AleNimo/Bode_Analyzer/Imagenes Manuales/Conectores_BNC.jpg

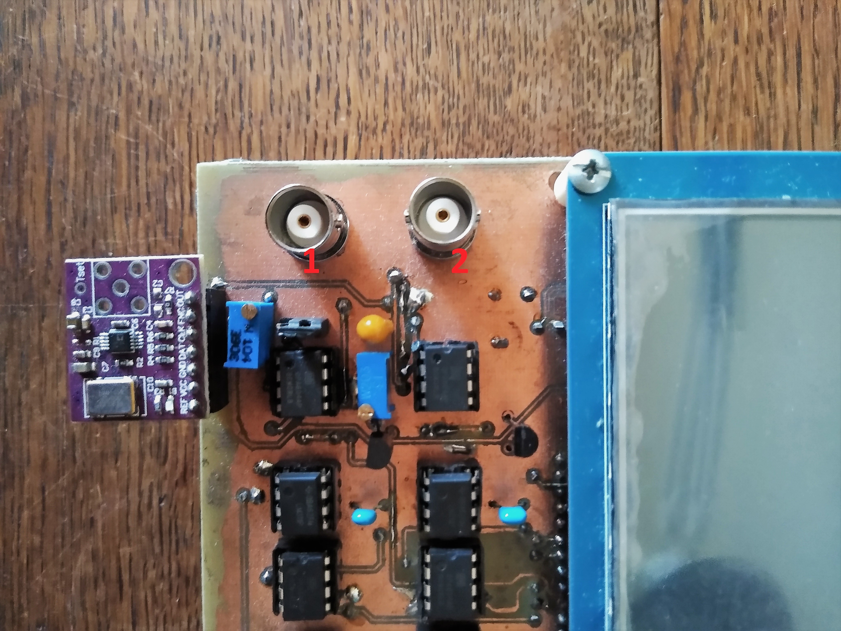
Imagenes Manuales/Conectores_BNC.jpg
