AleNimo/Bode_Analyzer/Imagenes Manuales/Cables_Alimentacion.jpg

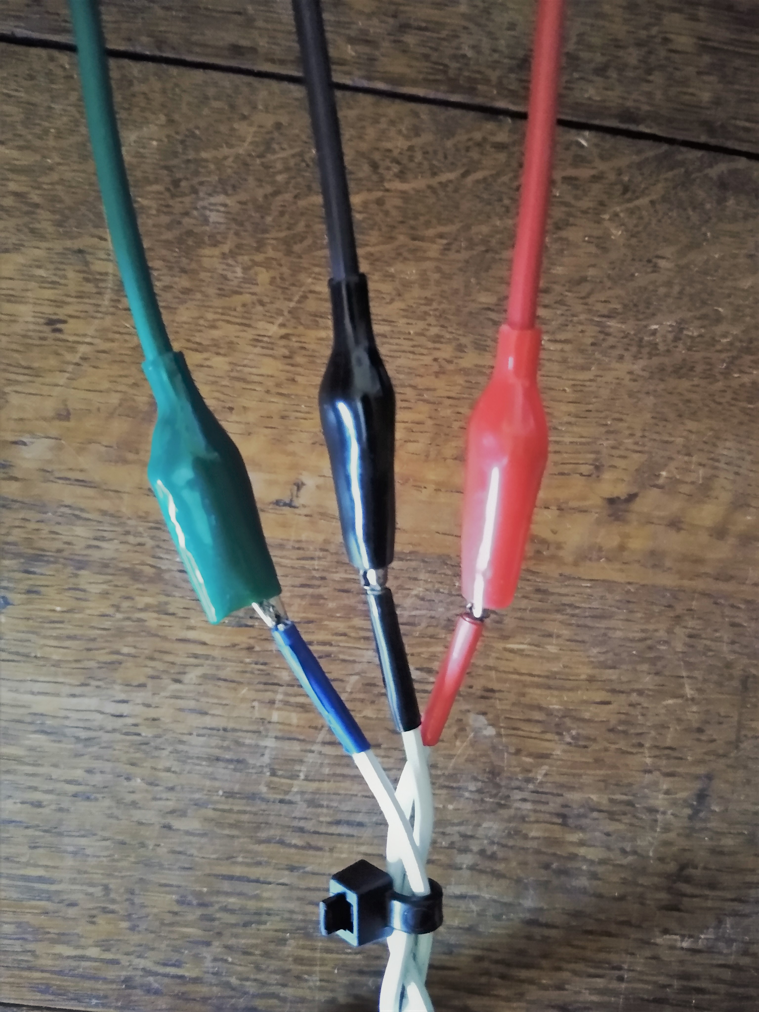
Imagenes Manuales/Cables_Alimentacion.jpg
