AleNimo/Bode_Analyzer/Bode_Analyzer Paper.pdf

# Bode Analyzer

Medicion de magnitud y fase de transferencias de filtros electr ´ | onicos. ´

1

st Alejo Domínguez Nimo

UTN FRBA
CABA, Argentina
adomnguez@frba.utn.edu.ar

2

nd Joaquín Mariano Pineiro ˜

UTN FRBA
CABA, Argentina
jpineiro@frba.utn.edu.ar

Abstract—Conocer y caracterizar la respuesta de un filtro de un sistema LTI (lineal e invariante en el tiempo) resulta de gran utilidad para cualquier proyecto electronico, en tanto ´ que permite corroborar aquella respuesta física con la calculada analíticamente y simulada. Este trabajo detalla el desarrollo de un dispositivo capaz de medir la magnitud y la fase de la transferencia de un filtro de forma automatizada, a partir de un barrido en frecuencia acondicionado por un hardware externo y posterior procesamiento digital. Como resultado se obtuvo un dispositivo capaz de medir frecuencias entre 1Hz a 20KHz, con modulo entre 0dB y -45dB. ´
Index Terms—Module, Phase, Filter, Bode, OPAMP, Frequency
I. INTRODUCCION´

A la hora de disenar un filtro, los pasos a seguir son ˜
diseno, simulaci ˜ | on e implementaci ´ | on. Si bien la simulaci ´ | on´
permite corroborar la plantilla de diseno, y determinar si el ˜ filtro produce el efecto deseado a distintas frecuencias, los componentes que constituyen la arquitectura del filtro, estan´ sometidos a distintos factores de variacion como, tolerancias, ´ temperatura, ruido electrico, y a otros factores vinculados ´ con la tecnología de fabricacion del componente elegido. ´ Muchos de estos efectos pueden ser simulados, pero otros resultan difíciles de computar, o por lo menos requieren una verificacion experimental. Por lo tanto, dependiendo de la ´ importancia del comportamiento del filtro, no es trivial conocer la respuesta real del mismo.
Esta verificacion experimental puede ser implementado con ´ otros instrumentos de medicion, como un osciloscopio y un ´ generador de senales. Sin embargo, lo tedioso y dependi- ˜
ente del operario que es este metodo de medici ´ | on resulta ´
en mediciones prolongadas en el tiempo y con alto nivel
de incertidumbre (en comparacion a una medici ´ | on con un ´
dispositivo dedicado, como la serie de productos “STEMlab” de Redpitaya [1], o el dispositivo “Bode 100” de OMICRON LAB [2]). Por estas razones, este trabajo propone una medicion´ automatizada de las magnitudes anteriormente mencionadas, a partir de un procesamiento analogico en conjunto con uno ´ digital.
| | II. MARCO TEORICO ´
A. Sistemas Lineales e Invariantes en el Tiempo
El termino sistema es sumamente amplio y abstracto. Sin ´ embargo un enfoque general lo concibe como una estructura
o diseno que opera sobre se ˜ | nales de modo de producir alg ˜ | un´
efecto sobre ellas. Particularmente, no resulta necesario determinar la constitucion f ´ ísica del sistema sino sus relaciones funcionales de forma tal de abstraerse de su construccion´ física.
Se denomina sistema (H) a un proceso que transforma senales temporales que ingresan a su entrada (x(t), x[n]) ˜ en otras que egresan de su salida (y(t), y[n]), mediante la interconexion de componentes, dispositivos o incluso ´ subsistemas.

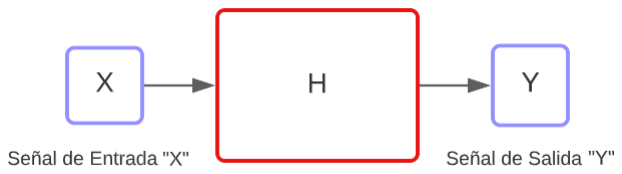
[picture p3: figure]

Fig. 1. La senal de entrada x(t) es transformada por el sistema (operador H), ˜ dando como resultado la senal de salida y(t) ˜

Los sistemas pueden ser descriptos en terminos matem ´ | aticos ´
a partir de ecuaciones algebraicas o ecuaciones diferenciales como y(t) = 2x

2
(t−1) ó y

′
(t) + 2y(t) = 4x(t)
. Adoptando el
concepto de transferencia, donde una funcion de excitaci ´ | on (de ´
entrada x(t)
) ingresa al sistema, y se convierte en una funcion´ de salida, que puede ser descripta a partir del sistema cono-
ciendo la funcion matem ´ | atica que lo describe: ´ | y(t) = T[x(t)

].
Existen muchas clasificaciones para los sistemas, pero particularmente los que interesan son los electricos que responden ´ a cuestiones físicas. Sus características principales son: invariabilidad temporal y linealidad. Un sistema se denomina lineal si cumple simultaneamente con las propiedades de aditividad ´
(1) y homogeneidad (2).

T[x1(t) + x2(t)

] = y1(t) + y2(t)
(1)
T[α · x(t)

] = α · y(t)
(2)

Un sistema es invariante en el tiempo si el comportamiento y características del mismo no cambian con el transcurso del tiempo, es decir, al desplazar su entrada un tiempo t0 la respuesta original se desplaza el mismo tiempo t0, sin cambios (3).

T[x1(t)

] = y(t) ⇒ T[x1(t−t0)

] = y(t−t0)
(3)

Por lo tanto un sistema se denomina LTI si cumple con (1),
(2) y (3).
B. Respuesta al Impulso e Integral de Convolucion´
Cualquier senal temporal puede describirse en t ˜ | erminos de ´
un conjunto de senales impulso escaladas y desplazadas en el ˜ tiempo (4). Ademas, puede evaluarse la respuesta del sistema ´
a una senal impulso ˜ | δ(t)
, definida como “Respuesta Impul-
sional” (5). De esta manera, al expresar la senal ˜ | x(t) como
combinacion de se ´ | nales impulsos escaladas y desplazadas ˜
y aplicarla a un sistema LTI, se obtendra la suma de las ´ respuestas impulsionales h(t) escaladas y desplazadas. Así, puede obtenerse la respuesta del sistema sin tener que recurrir a las ecuaciones diferenciales que lo modelan.

x(t) =

Z ∞

τ=−∞

x(τ)δ(t−τ)dτ | (4)

h(t) = T[δ(t)

] = y(t)

|x(t)=δ(t)
(5)

Sabiendo esto, es posible obtener una forma matematica que ´ describe la respuesta de salida y(t) a partir de la excitacion´ x(t) y respuesta al impulso h(t)
(6):

y(t) = T

Z ∞

τ=−∞

x(τ )δ(t − τ )dτ
(6)

y(t) =

Z ∞

τ=−∞

x(τ )h(t − τ )dτ = x(t) ∗ h(t) (7)

Donde la ecuacion (7) se denomina ´ | Integral de Convolucion´ .
C. Transformada de Fourier

Hasta este punto se conoce una forma de caracterizar el sistema en terminos del tiempo. Pero un filtro se caracteriza ´
en terminos de la frecuencia. Por lo tanto es l ´ | ogico aplicarle ´
a la expresion (7) una transformada que vincule el dominio ´ temporal con el frecuencial; la transformada de Fourier F[]. Aplicando la propiedad que posee esta transformada con la
convolucion se obtiene una expresi ´ | on (8), mucho mas sencilla ´
que vincula variables de salida con entrada. De esta manera el sistema puede ser descripto en terminos del cociente entre ´ la entrada y salida (9) a partir de su modulo |H(f)
| | y su fase

ϕ(f)

F[y(t)

] = F[x(t) ∗ h(t)

] ⇒ Y(f) = X(f)

- H(f)
(8)

H(f) =

Y(f)

X(f)

=

|Y(f)

|X(f)

e

j(ϕ(Y )−ϕ(X)) = |H(f)
| · e

jϕ(f)

(9)

D. Senales Arm ˜ | onicas ´
Conociendo las expresiones que vinculan frecuencialmente
entrada y salida, ¿como se obtiene H(f)? ¿con que se ´ | nal se ˜
excita al sistema? Estas dos preguntas no resultan triviales,
pues hay una unica se ´ | nal que resulta la m ˜ | as conveniente ´
para excitar un sistema. Hay que tener cuenta que una senal ˜ normalmente es poliarmonica, es decir, que esta compuesta ´ por sumatorias de senos y cosenos. Tomando como ejemplo una senal cuadrada x(t), al excitar con ella el sistema, el ˜ mismo responde con una determinada senal y(t). Al aplicar ˜ la transformada de Fourier tanto a x(t) como a y(t), podemos obtener X(f) e Y(f) y realizar el cociente para hallar H(f) como se vio anteriormente. Sin embargo, este proceso requiere del procesamiento de las senales temporales con la transformada ˜ discreta rapida de Fourier (FFT) para poder hacer el cociente. ´
Por esta razon la se ´ | nal m ˜ | as conveniente para aplicar este ´
analisis es una se ´ | nal arm ˜ | onica sinusoidal (10). De esta manera, ´
al excitar con un seno, de la ecuacion (11) se deduce que la ´
senal de salida tambi ˜ | en ser ´ | a un seno de la misma frecuencia ´
pero con su amplitud y desfasaje afectados por H(f)

x(t) = K · e

j·w0t+ϕ0 ⇒ X(f) = K · δ(f−f0)
- e

j·ϕ0
(10)
Y(f) = K · δ(f−f0)
- e

j·ϕ0
- H(f) = K · e

j·ϕ0
- H(f0)
(11)
Y(f) = A · e

j·ϕ1 = K · e

j·ϕ0
- H(f0)
(12)
Y(f) = K · e

j·ϕ0
- |H(f0)

| · e

jϕH | (13)

Resultando en:

|H(f0)

| =

A
K

(14)

ϕH(f) = ϕ1(f) − ϕ0(f)
(15)

Entonces, midiendo la amplitud y el desfasaje existente entre x(t) e y(t) a una frecuencia f0 se obtiene facilmente ´ el valor complejo de H(f0)
, sin usar la transformada de Fourier.

III. METODOLOGÍA GENERAL

El proyecto consiste en la construccion de un circuito ´
impreso, la programacion de un software bajo la supervisi ´ | on´
de un sistema operativo FreeRTOS, en conjunto con un Framework para manejo de interfaces graficas ´ TouchGFX [3]; y la calibracion del sistema de manera de cuantizar la ´ incertidumbre de las mediciones. El circuito impreso consta de 2 capas y 130 vías, hecho con la tecnica de planchado y ´ acidado con percloruro ferrico. Los componentes que posee ´ la placa son resistencias y capacitores SMD 0805, y circuitos integrados DIP-8. Para la CPU se utilizo un cortex M4 ARM ´ STM32F401RE [4] embebido en una placa de STM NUCLEO-F401RE [5] y para la interfaz grafica una pantalla TFT con ´
un controlador ILI9341 [6]. La senal senoidal de excitaci ˜ | on es ´
producida por un generador de senales programable ˜ | AD9833
[7], que utiliza tecnología DDS (Direct Digital Synthesis), la cual se basa en generar una senal digital variable en el tiempo ˜
y luego realizar una conversion digital a anal ´ | ogico de dicha ´
senal. ˜

IV. MEDICION´

A. Principio de Medicion´
Como se describio anteriormente, la medici ´ | on completa ´
consiste en poder obtener la fase y modulo de la transferencia ´ de un filtro.
Para medir estos dos parametros, podr ´ | ía realizarse un
muestreo con la CPU y una posterior FFT. Sin embargo, este procedimiento para el microcontrolador utilizado resulta demasiado costoso computacionalmente, y limitante en cuanto al hardware necesario (demasiada velocidad de ADC requerida,
etc.). Por esta razon se opt ´ | o otro m ´ | etodo de medici ´ | on, en el ´
que la amplitud y el desfasaje temporal entre las dos senales ˜ se realiza de manera directa.
Para ello, se propone para |H(f)
| | | | acondicionar ambas
senales transform ˜ | andolas en valores de tensi ´ | on continua que ´
sean iguales al valor maximo de cada una respectivamente. Es- ´
tas senales continuas son le ˜ | ídas por dos canales del conversor
digital analogico (ADC) del MCU. ´
Para ΦH(f)
se propone detectar los cruces por cero de ambas senales de forma coherente, es decir en ambas pendientes ˜ ascendentes o ambas descendentes. En este caso, con un comparador se generan senales cuadradas a partir de las senoidales, ˜ para que sea mas f ´ acil determinar los instantes de tiempo a ´ evaluar de forma digital. De esta manera, el MCU deberá contar el tiempo entre flancos ascendentes o descendentes de
ambas senales (se decidi ˜ | o utilizar los ascendentes). ´
B. Diagrama en Bloques - Hardware
En la Fig. 2 se muestra un diagrama en bloques del dispositivo.
C. Acondicionamiento de Senales ˜
La generacion de una se ´ | nal continua que representa el valor ˜
pico de ambas senoidales de entrada y salida se realiza a traves de un circuito detector de pico (Fig. 3), constituido ´ por un comparador LM311 [8], un amplificador operacional OPA604APG [9], un diodo Schottky, un capacitor y un transistor mosfet canal N.
De forma breve, el funcionamiento se basa en la carga de un capacitor a traves de un comparador que se activa cuando ´ la tension de entrada es mayor a la de salida del buffer (la cual ´
es igual a la tension del capacitor). Cuando dicha tensi ´ | on de ´
salida supera levemente la de entrada (VIN), el comparador se desactiva y el capacitor mantiene su tension por un tiempo ´ relativamente alto dado que la descarga es a traves de la ´ corriente en inversa del diodo y la de entrada del operacional. Notar que el transistor presente se conecta en paralelo al capacitor y es controlado por una salida de la CPU. Al cambiar a otro punto de frecuencia, puede que el nuevo valor pico de salida sea menor que el medido anteriormente, por lo que el capacitor debe descargarse antes de volver a realizar una medicion. Al activar el MOSFET, se cortocircuita el ´
capacitor descargandolo r ´ | apidamente. ´
Por otro lado, la generacion de las se ´ | nales cuadradas para ˜
detectar el desfasaje se realiza con un comparador LM311
con un lazo de realimentacion de hist ´ | eresis (Fig. 4). De esta ´
manera, ambas senales son m ˜ | as robustas al ruido que pueda ´
haber en el sistema dado que impide que este genere falsos flancos a la salida de los comparadores cuando las senales ˜ senoidales se encuentran cerca del cero.
El valor pico de la senal senoidal de excitaci ˜ | on generada ´
por el AD9833 es de apenas unas centenas de mV y ademas´ con un nivel de continua indeseado para nuestro analisis. Para ´ aprovechar mejor el rango dinamico del ADC del microcon- ´ trolador, se filtra el nivel de continua con un filtro pasa-altos,
y se amplifica la senal a una tensi ˜ | on pico de 3.3V (tensi ´ | on de ´
referencia del ADC) con un amplificador no inversor como el
de la (Fig. 5). El proposito del jumper J5 y R4 ser ´ | a explicado ´
con mas detalle en el apartado de calibracion (Secci ´ | on VIII). ´
D. Metodo de Medici ´ | on´
El metodo de medici ´ | on se subdivide en 3 etapas: ´
1) Seleccion de rango de medici ´ | on desde la UI. ´
2) Medicion de amplitud. ´
3) Medicion de fase. ´
1) El usuario controlara desde la UI el rango de frecuencias ´ que desea medir y la cantidad de puntos por decada ´
que desee. Luego con el boton ”Medir” comenzar ´ | á
la medicion, donde el MCU controlar ´ | a todo el ´
procedimiento.
2) Con los rango obtenidos de la UI, el MCU comanda al
generdor de senales para que genere una se ˜ | nal senoidal ˜
con la primer frecuencia del barrido. Se descargan los capacitores de los detectores de pico durante 1ms, y luego de un tiempo de espera para estabilizar las
senales el ADC del MCU genera una conversi ˜ | on de ´
10 muestras para ambos canales (senal de entrada y ˜ salida). Estas son promediadas; con el valor obtenido se realiza el cociente de Vout y Vin para obtener |H(f0)|.
3) Una vez realizada la medicion de amplitud, el MCU ´
comenzara la medici ´ | on de fase si el m ´ | odulo medido ´
fue mayor a -30dB, y si la frecuencia es menor a
20kHz, explicado a continuacion en la secci ´ | on de ´ | Rango
de Medicion´ . Un timer dedicado del microcontrolador
detectara un flanco ascendente de la se ´ | nal de entrada, ˜
y cuando ocurra esto, almacenara el valor actual de ´ la cuenta del mencionado timer. Al ocurrir luego un flanco ascendente pero esta vez de la senal de salida, ˜ nuevamente se almacena el valor de la cuenta. Con los valores obtenidos se calcula el desfasaje temporal, y posteriormente el desfasaje en grados sexagesimales.

Terminada la medicion, el MCU cambia a la siguiente ´ frecuencia (siguiente punto de medicion) y se repite el pro- ´ cedimiento. Una vez terminado el barrido de frecuencia, en la
UI se actualizan los graficos de m ´ | odulo y fase. ´

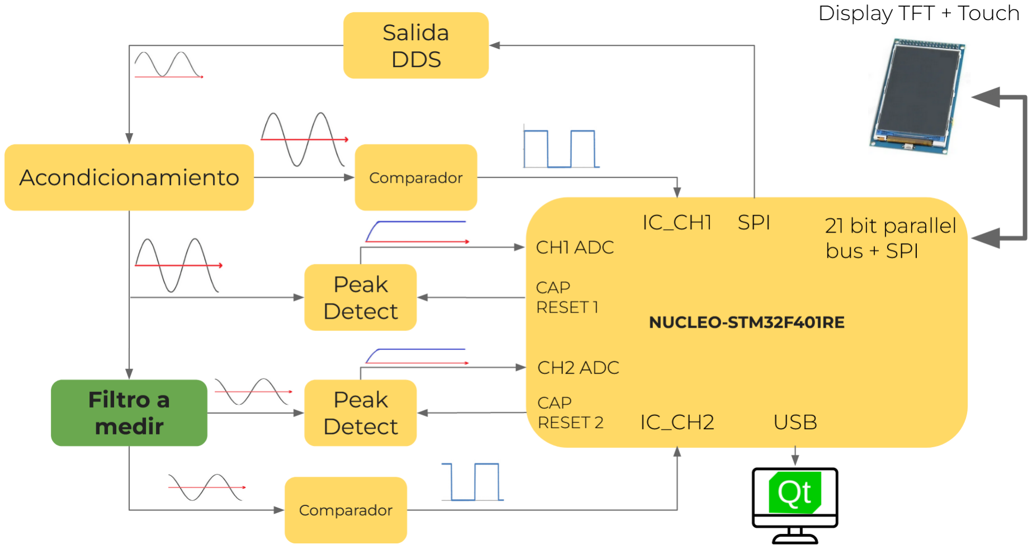
[picture p4: figure]

Fig. 2. Diagrama en bloques del hardware

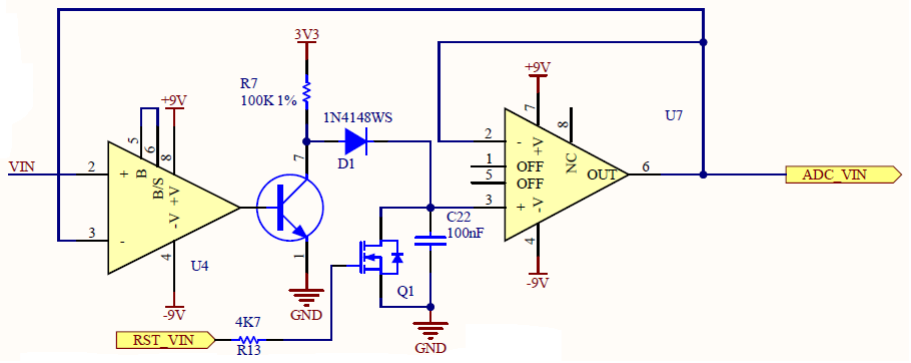
[picture p5: figure]

Fig. 3. Circuito detector de pico

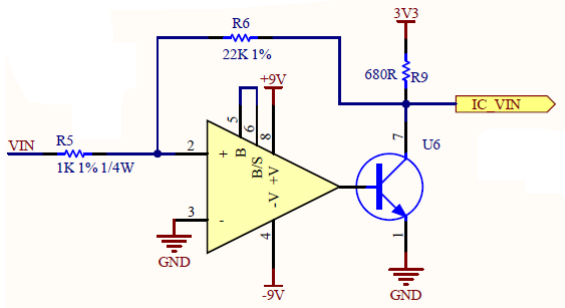
[picture p6: figure]

Fig. 4. Circuito comparador con histeresis ´

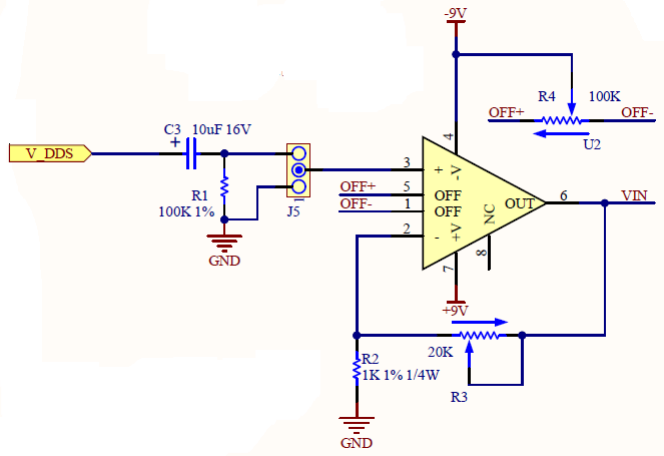
[picture p7: figure]

Fig. 5. Acondicionamiento de senal generada: filtro pasa altos y amplificador ˜ no inversor

E. Rango de Medicion´

El rango de medicion queda determinado por las carac- ´ terísticas del filtro, y las limitaciones de hardware analogico ´ y digital.
1) Magnitud: El límite superior es siempre de 0dB para toda frecuencia dado que se excita al filtro con una senal ˜ que tiene el pico igual a la tension de referencia del ADC ´ (de manera de aprovechar su rango dinamico), si el filtro es ´ activo o tiene un realce eso no se podría medir teniendo en cuenta que saturan las cuentas del conversor. Para frecuencias menores a 20Hz el rango en la medicion de magnitud queda ´

limitado entre 0dB y -16dB debido a que el ripple por la descarga del capacitor del detector de pico a baja frecuencia es considerable a amplitudes bajas (menores a 200mV). Para frecuencias mayores a 20Hz y hasta 20kHz el rango está limitado entre 0dB y -44dB dado que el detector de pico conectado a la salida del filtro puede disminuir su valor solo ´ hasta 20mV.
2) Fase: La medicion de fase est ´ | a limitada por la hist ´ | eresis ´
y el umbral propio que tiene el comparador para discernir en un cruce por cero, y ademas por las limitaciones propias del ´ timer de la CPU.
No es posible medir desfasajes de senales menores a 35mV ˜
debido a que estan por debajo de los umbrales de hist ´ | eresis ´
de los comparadores. Por esta razon solo se mide fase si el ´ modulo medido con anterioridad es mayor a -30dB (valor ´ elegido con cierto margen de seguridad). Por otro lado, tambien hay limitaciones para el desfasaje a frecuencias altas ´ (mas de 25kHz) debido a que los canales de input capture del ´ timer del microcontrolador dejan de responder de forma rapido ´ a los flancos ascendentes producidos por el comparador.
Por estas razones, la medicion de fase est ´ | a limitada a un ´
rango entre 1Hz y 20KHz, cuando la magnitud es mayor a -30dB. Teniendo en cuenta estas restricciones, los valores de fase no tienen limitaciones en su medicion: se muestran en ´ grados sexagesimales desde -180° hasta 180°.
V. FIRMWARE
A. Principio de funcionamiento

El algoritmo esta compuesto de un total de 6 tareas: ´
inicializacion del hardware ´ | ”StartHardwareTask”; monitoreo
de medicion´ ”MeasureTask”; medicion de amplitud ´ | ”Module-
Task”; medicion de fase ´ | ”PhaseTask”; envío de datos por USB
”USBTask”; refresco de pantalla que corre dentro del motor
grafico, ejecutado peri ´ | odicamente a trav ´ | es de un timer. ´
1) ”StartHardwareTask” se encarga de inicializar el motor
grafico de TouchGFX y establecer la comunicaci ´ | on´
USB.
2) ”MeasureTask” se encarga descargar los capacitores de los detectores de pico durante 1ms, recalcular y cambiar la frecuencia de la senal de entrada, generar una ˜ demora de 1s para que se estabilicen las senales, iniciar ˜
la medicion de amplitud con ´ | ”ModuleTask” y, si la
frecuencia y la magnitud medida estan dentro del rango ´ permitido, procede a realizar la medicion de fase con ´ ”PhaseTask”. Finalizadas las mediciones, se comunica con el motor grafico para actualizar las pantallas con los ´
valores de modulo y fase, y con ´ | USBTask para enviar
los datos por USB, para mostrar los graficos en la PC. ´
3) ”ModuleTask” sincronizado con ”MeasureTask”, genera 10 conversiones del ADC separadas 54.67µs entre sí de ambas senales pico de entrada y salida. Luego de la ˜ adquisicion se promedia y se calcula la magnitud en ´ decibeles.
4) ”PhaseTask” sincronizado con ”MeasureTask”, se activan las entradas que detectan flancos, y una vez sucedidos dos eventos de flancos ascendentes como se describio anteriormente, se calcula la diferencia temporal ´ y posteriormente el desfasaje en grados sexagesimales. Obtenido este valor se analizan los casos en que la fase supera 360° para descartar una mala deteccion (posible ´ a alta frecuencia), y el caso en que la fase supere -180°. Para el primero genera una nueva medicion, y para el ´ segundo se realiza un wrap de la fase para llevarla al primer cuadrante. Para este procedimiento, tambien se ´ toman 10 muestras de la fase.
5) ”USBTask” sincronizado con ”MeasureTask”, envía por
comunicacion USB la medici ´ | on de magnitud, fase y los ´
valores de frecuencia.
En la siguiente pagina se muestra un diagrama de flujo del ´ algoritmo completo (Fig. 7).

VI. APLICACION EN TOUCHGFX ´

A. Pantallas
La aplicacion est ´ | a compuesta de 2 ´ | Pantallas. La primera
consiste en el menu de configuraci ´ | on (Fig. 6) en donde el ´
usuario puede a traves de tres sliders configurar: ´
1) Frecuencia maxima de medici ´ | on. El valor l ´ | ímite de este
parametro es 1MHz ´
2) Frecuencia mínima de medicion. El valor l ´ | ímite de este
parametro es 1Hz ´
3) Puntos por decada. El valor m ´ | ínimo es 1 y el valor
maximo 600. ´

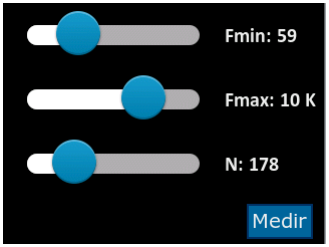
[picture p8: figure]

Fig. 6. Pantalla 1 de configuracion de frecuencia ´

La segunda es donde se muestra la magnitud y fase, en un grafico con el eje horizontal graduado en una escala ´ logarítmica para la frecuencia, y el eje vertical en una escala en decibeles para la magnitud (Fig. 8) o en grados sexagesimales al mostrar la fase (Fig. 9). Así mismo, en la esquina superior derecha de la pantalla hay un boton para cambiar entre el ´ grafico de la magnitud y la fase, y en la esquina superior ´
izquierda, un boton para volver al men ´ | u de configuraci ´ | on de ´
frecuencia.

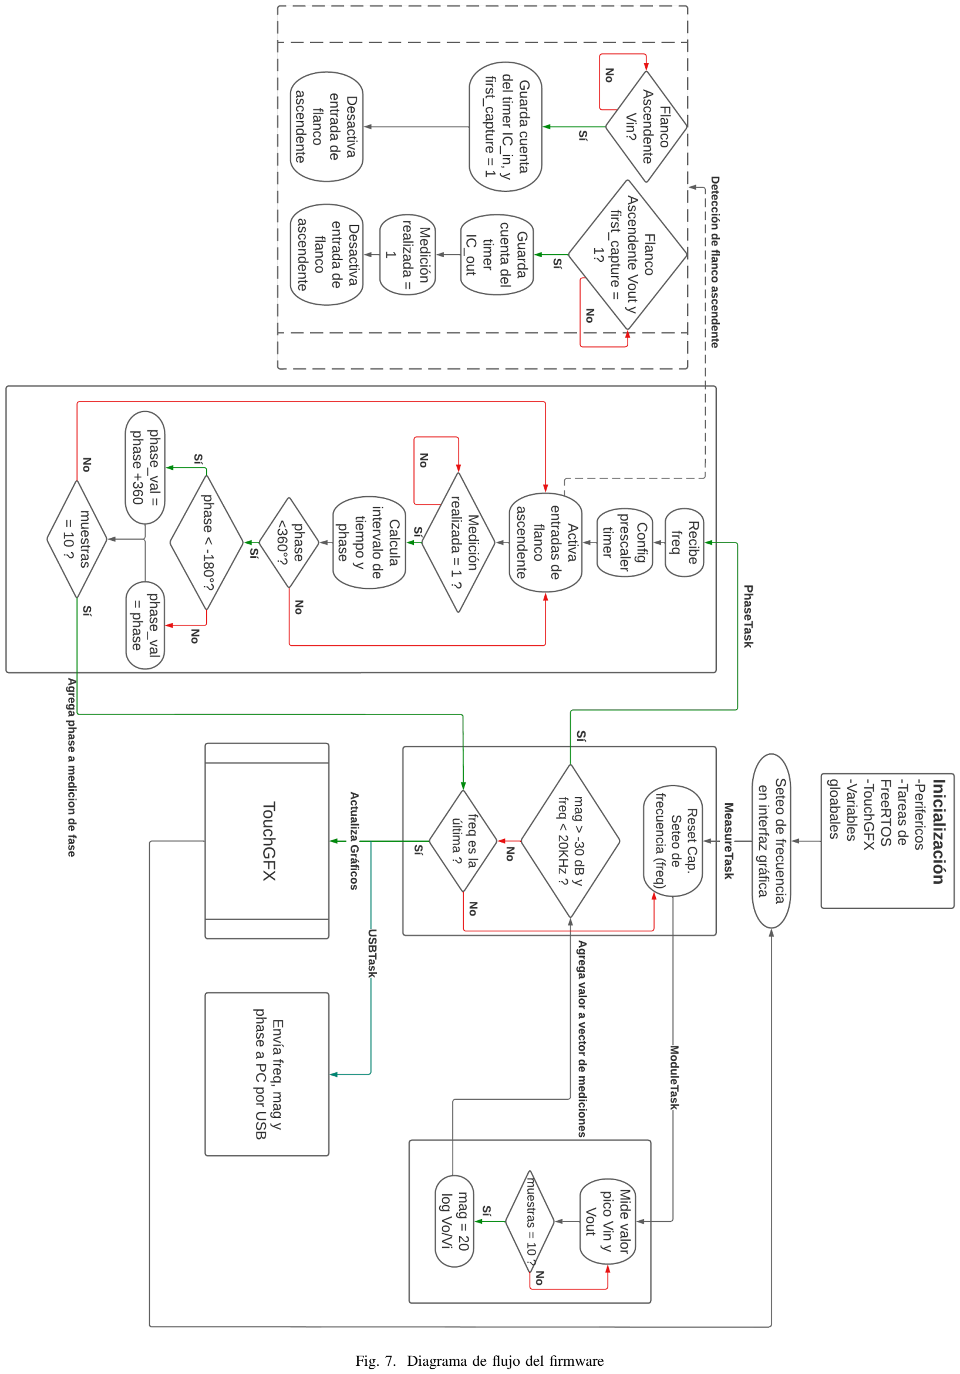
[picture p9: page 6]

Fig. 7. Diagrama de flujo del firmware

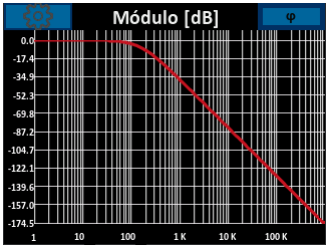
[picture p10: figure]

Fig. 8. Pantalla 2: grafico de m ´ | odulo ´

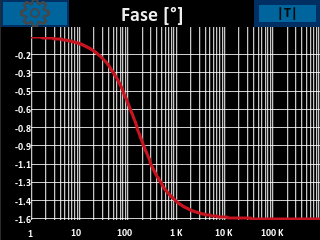
[picture p11: figure]

Fig. 9. Pantalla 2: grafico de fase ´

B. Logica de funcionamiento ´

A traves de los sliders el usuario puede configurar el ´ intervalo de frecuencia de medicion en conjunto con los puntos ´
por decada. Al presionar el bot ´ | on ”Medir”, se calcula el valor ´
maximo y m ´ | ínimo de frecuencia que se va a graficar en
pantalla. La escala horizontal siempre mostrara potencias de ´ 10 como decadas, por ejemplo, si se selecciona una frecuencia ´
mínima de 3Hz y maxima de 500Hz, la medici ´ | on ser ´ | a desde ´
3Hz hasta 500Hz pero el grafico se mostrar ´ | a desde 1Hz hasta ´
1KHz.
Luego el framework se comunica con el back-end del programa para calcular las frecuencias intermedias entre la
maxima y la m ´ | ínima en una escala logarítmica, separado un
valor del otro geometricamente equidistante. Calculados todos ´ los valores, el back-end comienza la medicion. ´
Finalizada la adquisicion de datos, el back-end se comunica ´ con el framework para actualizar los graficos. ´
VII. ANALISIS DE DISTORSI ´ | ON ARM ´ | ONICA ´ | DDS

Como se menciono anteriormente, el DDS, junto con ´ el acondicionamiento realizado, es utilizado para generar
una senal arm ˜ | onica que es requerida como se aclara en la ´
teoría. Sin embargo, en la practica no ocurre que la se ´ | nal ˜
sea puramente armonica, debido a distintos factores como la ´
resolucion del conversor digital anal ´ | ogico del DDS o, en caso ´
de no ser correctamente elegido, el slew rate del operacional en la etapa de acondicionamiento. Esto provoca una distorsion´ respecto de la senal senoidal deseada. Una forma de medir ˜
que tanto se distorsiona es analiz ´ | andola en el dominio de la ´
frecuencia. Si no hubiese distorsion (caso ideal) habr ´ | ía una
sola componente. En cambio, al haber distorsion aparecen ´ otras componentes armonicas en el espectro. ´
Estas distorsiones pueden provocar un error en la medicion´ si lo suficientemente grandes, por ejemplo en la deteccion´ del pico. Por lo tanto, es necesario caracterizar este efecto para saber si el DDS seleccionado es aceptable para los requerimientos tecnologicos del sistema. Existen dos ´ criterios para garantizar que la distorsion del generador sea ´ despreciable. Como primera instancia, se compara el pico
mas alto del arm ´ | onico indeseado con medio cuanto del ADC ´
del microcontrolador, para evaluar si el armonico afecta o no ´
al codigo obtenido del conversor. Si el valor de tensi ´ | on de ´
entrada es cercano a una transicion del ADC, entonces puede ´
que el armonico afecte al c ´ | odigo, pero esto mismo sucede con ´
el ruido. Por esta razon, como segundo criterio, se compara ´ el valor eficaz de la armonica indeseada con el valor eficaz ´ del ruido. Si la distorsion comienza a ser considerablemente ´
mayor al piso de ruido, entonces ademas de una variaci ´ | on´
aleatoria en las cuentas existe una variacion en las cuentas ´
por la distorsion arm ´ | onica del generador cuando la tensi ´ | on´
de entrada esta cercana a las transiciones del ADC.

El ensayo consiste en obtener 20 curvas de tension en ´ funcion del tiempo de distintas frecuencias desde 1Hz hasta ´ 20KHz (eligiendo valores separados exponencialmente), que es el rango normal de trabajo del equipo. Luego de esto se realiza una FFT a cada curva para detectar posibles armonicas ´ no deseadas, aplicando la ventana flat-top para medir correctamente los valores pico y la hanning para distinguir
correctamente los picos si estan muy pr ´ | oximos entre s ´ | í en
frecuencia (Fig. 10 y Fig. 11).

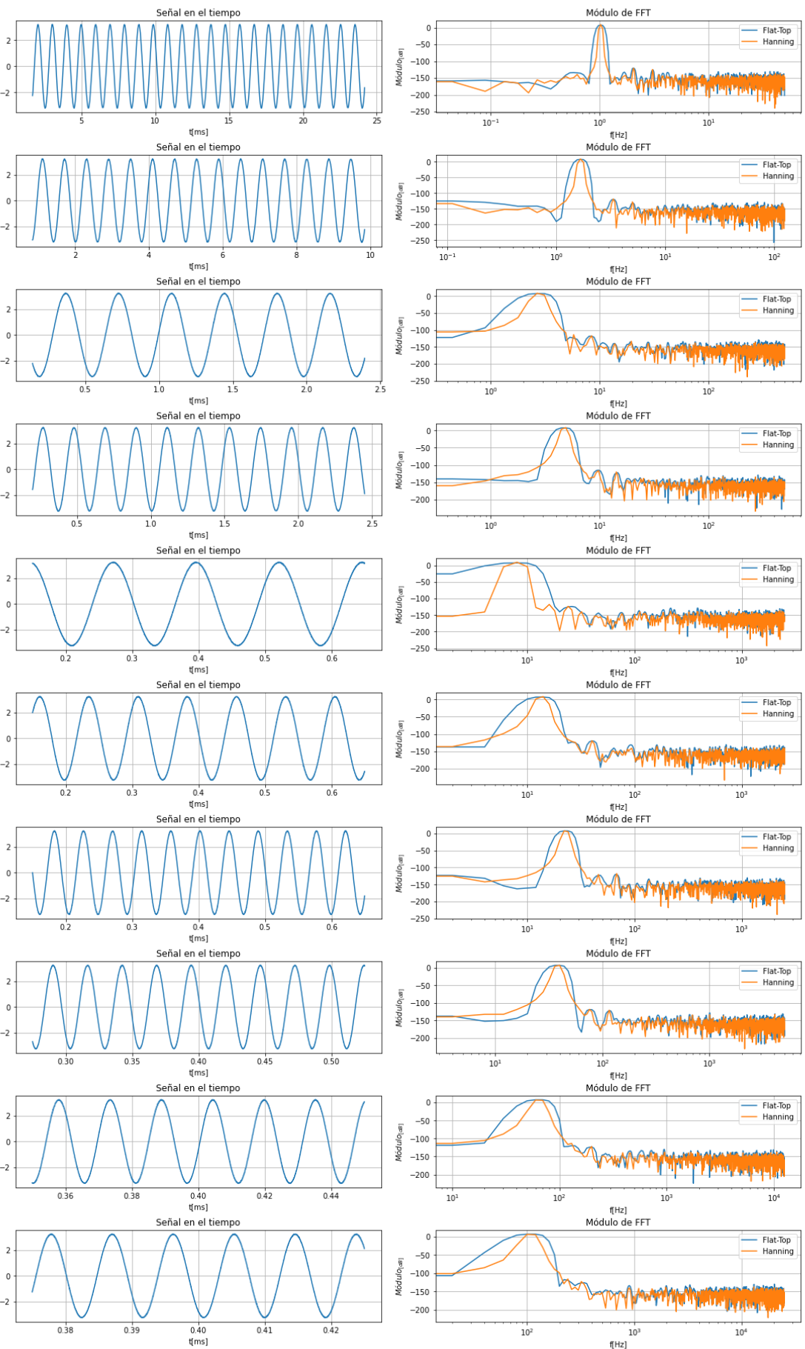
[picture p12: page 8]

Fig. 10. Ensayo de THD de 1Hz a 108.976Hz

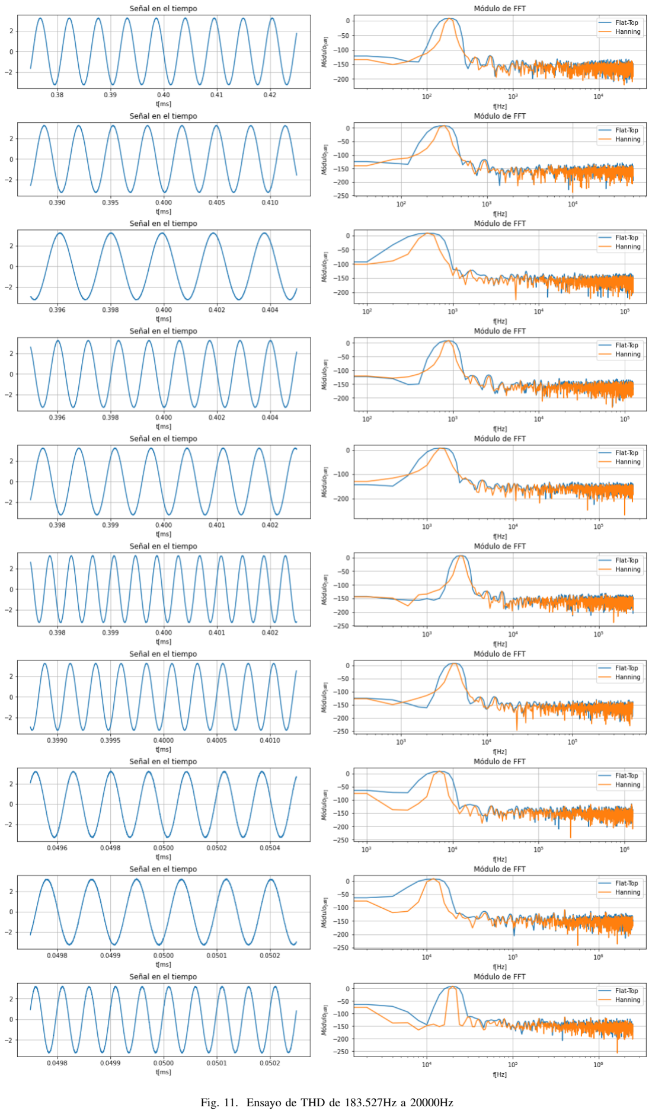
[picture p13: page 9]

Fig. 11. Ensayo de THD de 183.527Hz a 20000Hz

A. Analisis de Resultados ´
Como se observa en la Fig.10 y 11, los posibles picos que podrían deberse a la distorsion arm ´ onica, se encuentran ´ siempre a menos de -100dBV. Por lo tanto aplicando el primer criterio mencionado, se compara medio cuanto q (16) con el valor pico de -100dBV multiplicado por dos, debido a que si bien se muestra el espectro positivo, la FFT distribuye la
potencia de la senal en espectro positivo y negativo ( ˜ | Vx (17)).

q
2

=

Vref
2N · 2

=

3.3V
4096 · 2
= 402.8µV | (16)

Vx = 2 · 10

−100dB
20 | = 20µV | (17)

Como se puede observar el valor pico de las armonicas que ´ distorsionan no llegan a medio cuanto del ADC, por lo que no produce un error grosero para que el ADC resuelva entre dos cuentas adyacentes.
Por otra parte, tampoco se observa que dichas armonicas ´ superen en gran medida al piso de ruido. Entonces, estas no
producen mas error que el ruido cuando la tensi ´ | on de entrada ´
esta pr ´ | oxima a una transici ´ | on del ADC. ´

VIII. CALIBRACION´

En este apartado se explica como se realiza la calibracion´ del conversor analogico digital del MCU utilizado y a su ´ vez como utilizar los resultados obtenidos para corregir una ´
medicion de cuentas. Tambi ´ | en se explica la calibraci ´ | on de un ´
intervalo de tiempo medido con canales de input capture del MCU; al igual que para la calibracion del ADC, se desarrolla ´ el procedimiento para utilizar los resultados obtenidos en la del intervalo de tiempo.
A. Calibracion de ADC ´
Se obtiene la transferencia del ADC, y se almacena en la memoria FLASH del microcontrolador. Luego se realiza una interpolacion lineal para cada cuenta obtenida del ADC, de ´ manera de obtener la tension de entrada aproximada que la ´ genero.´
La calibracion consta de un generador de se ´ | nales arbitrario ˜
Rigol DG5070 [10] controlado con una computadora mediante USB, que genera una rampa escalonada de 1024 niveles de tension de 0V a 3.3V mantenidas 4ms cada una. El microcon- ´ trolador realiza 3 lecturas separadas 1ms entre sí comandado por la misma PC que controla al generador, y devuelve el resultado de la medicion a la PC. ´
Se promedian los valores de tension correspondientes a ´ un mismo codigo, y luego se hace un ajuste lineal de la ´ transferencia (Fig. 12). Con los valores de la transferencia ajustada a una recta se genera una matriz de 1024 filas (puntos de medicion), y dos columnas siendo la primera de ´
cuentas y la segunda de la tension de entrada en funci ´ | on de ´
la cuenta obtenida.

Teniendo esta matriz en la flash del microcontrolador (const float transf ADC[PUNTOS]), cada vez que se obtenga una

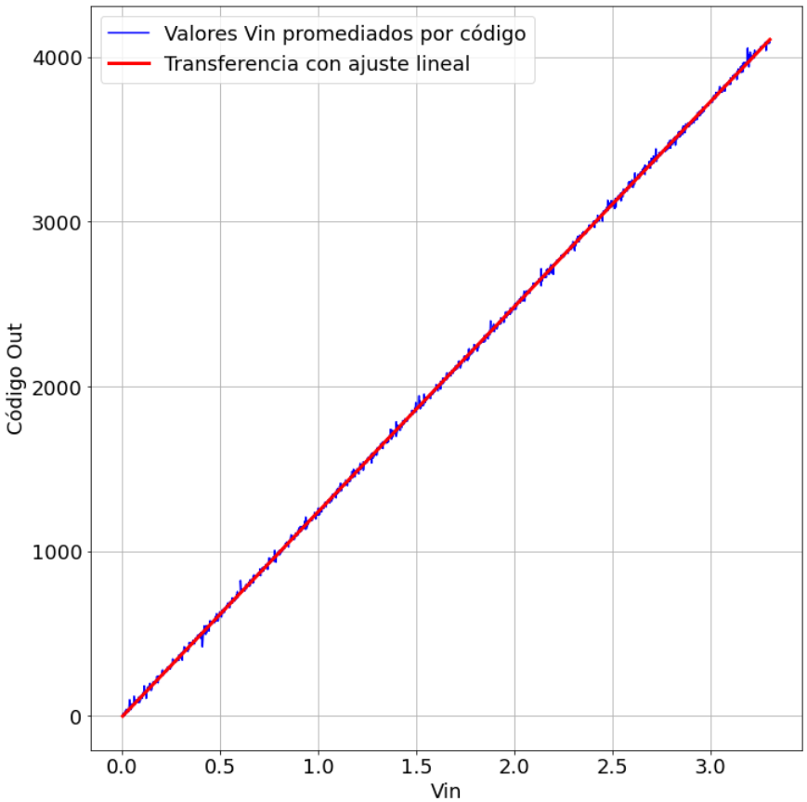
[picture p14: figure]

Fig. 12. Transferencia de ADC

cuenta (C) con el conversor se debe encontrar la cuenta de la matriz que sea inmediatamente menor a la cuenta
obtenida (CINF ), la cual tendra su respectiva tensi ´ | | | on de ´
entrada (VINF ), y la cuenta que sea inmediatamente mayor
(CSUP ) tambien con su respectiva tensi ´ | on anal ´ | ogica ( ´ | VSUP ).
Con estos valores se realiza el siguiente calculo: ´

VIN =

VINF (CSUP − C) + VSUP (C − CINF )

CSUP − CINF

| | | (18)

El cual se deduce de averiguar la ecuacion de la recta que ´ pasa por los puntos (CINF , VINF ) y (CSUP , VSUP ). En otras palabras, una interpolacion lineal. ´

B. Calibracion de timer con Input Capture ´
Se utiliza como patron un frecuenc ´ | ímetro Protek U2000A
[11] utilizado como medidor de intervalo de tiempo promediado por 100 mediciones. Con el generador de senales Agilent ˜ 33500 [12] se generan dos senales cuadradas a modo de evitar ˜ error de trigger del frecuencímetro, y se mide el desfasaje temporal de las mismas. La medicion se realiza desde 1us hasta ´ 1s con el microcontrolador y con el frecuencímetro. En este ensayo tambien se obtiene una matriz de dos columnas (valor ´
del timer y valor de patron) y 25 filas (puntos de medici ´ | | | on). ´
Las mediciones se encuentran separadas exponencialmente debido a que es mas probable que se produzcan intervalos ´ de tiempo de microsegundos hasta las decenas milisegundos, que a del orden de las decimas segundo en adelante (dado ´ que esto solo ocurre con valores de fase grandes en baja frecuencia) (Fig. 13). Luego esta matriz es almacenada en la FLASH y utilizada por el MCU en cada medicion de tiempo, ´ para corregir el resultado utilizando una interpolacion lineal ´ identica a la utilizada para calibrar el ADC. ´

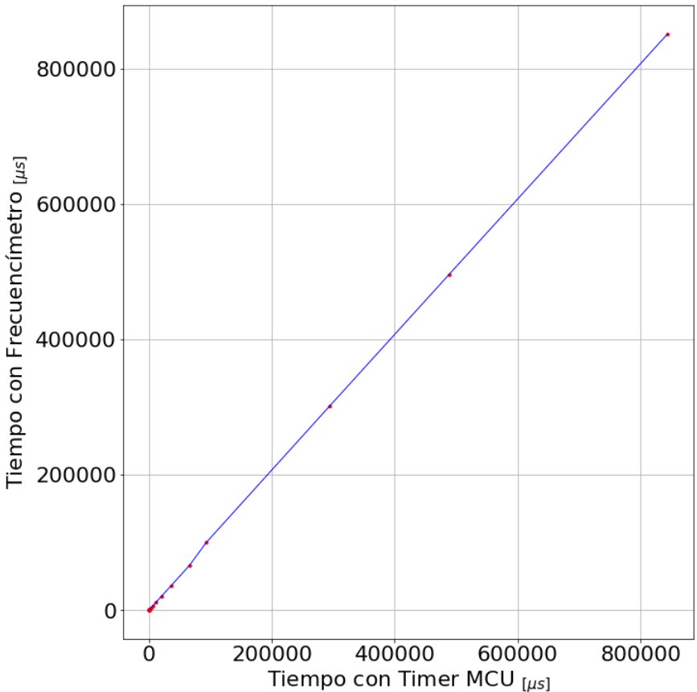
[picture p15: figure]

Fig. 13. Calibracion de medici ´ | on de intervalo de tiempo ´

IX. INCERTIDUMBRE

Se tiene incertidumbre tipo A en los valores de tension´ medidos con el ADC, y en los valores de intervalo de tiempo medidos con el timer, dado que se toman 10 muestras de
la tension de entrada al filtro, 10 muestras en la tensi ´ | on de ´
salida y 10 muestras de intervalo de tiempo respectivamente.

Estas muestras son almacenadas por el MCU, y en cada punto de medicion de frecuencia se realiza una ´ transferencia por USB con una aplicacion que se ejecuta en ´ una computadora aparte.

La aplicacion calcula los valores medios y las incertidum- ´ bres TIPO A para cada punto de frecuencia de: la tension de ´ entrada al filtro, la tension de salida y el intervalo de tiempo. ´ Con los datos aportados por los manuales del generador arbitrario utilizado en la calibracion del ADC y el manual del ´ frecuencímetro utilizado en la calibracion del input capture, ´ se calcula la incertidumbre tipo B de las mismas magnitudes mencionadas en el parrafo anterior, y con ellas las combinadas. ´ Para obtener las incertidumbres combinadas del modulo y ´ de la fase, se aplica la teoría de propagacion de incertidumbre, ´ calculando las derivadas parciales que correspondan.
Luego de varias pruebas se determina que tanto las 10 mediciones de las cuentas devueltas por el timer del input capture como las 10 mediciones de las cuentas entregadas por el ADC, resultan precisas, es decir, que practicamente no hay ´ incertidumbre en el estudio TIPO A, por lo que se considera que la mayor parte del error proviene del estudio TIPO
B. Entonces, todas las incertidumbres combinadas poseen
distribucion uniforme y se expanden al ´ | 95% con k =

√
3.

La incertidumbre en cada magnitud medida se expresa de forma grafica con una banda del intervalo de confianza sobre ´ el mismo grafico que muestra magnitud y fase por separado. ´ En las figuras 14, 15, 16, 17 se muestran como ejemplo las mediciones de un filtro pasa-bajos RC y un filtro Notch pasivo.

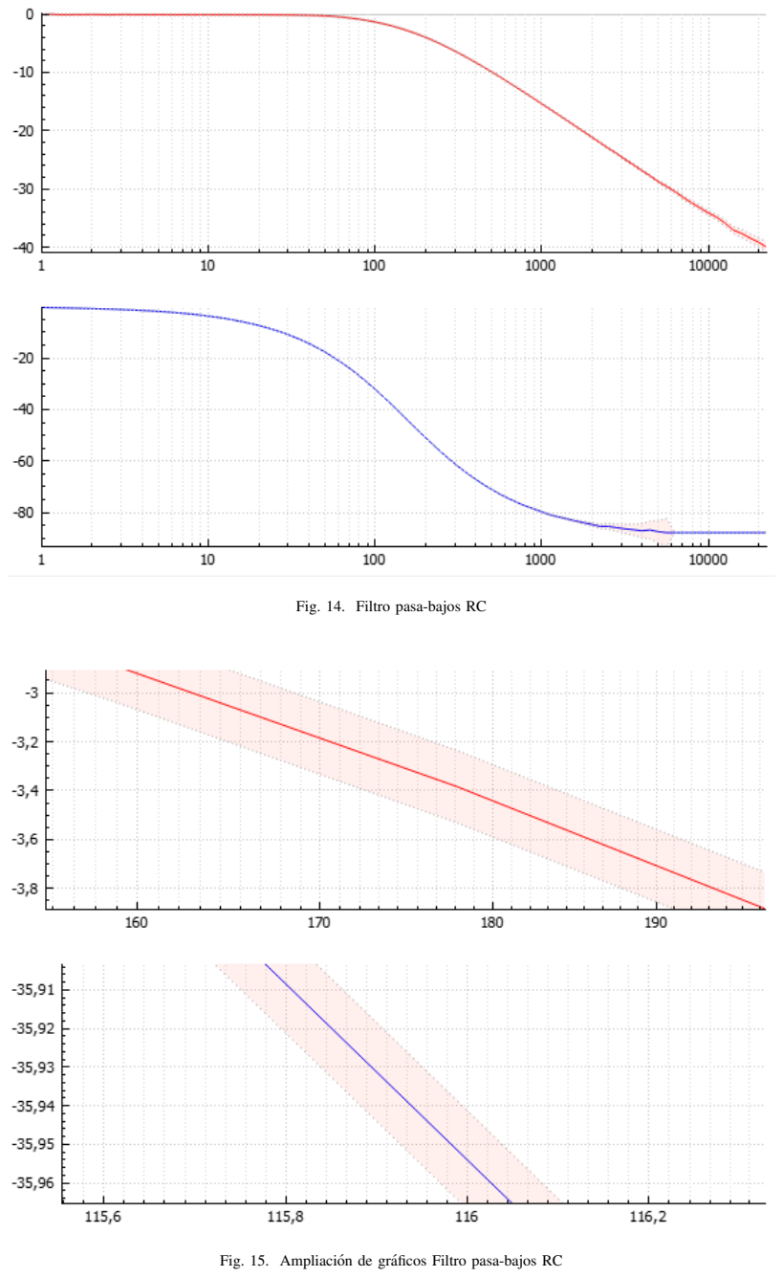
[picture p16: page 12]

Fig. 14. Filtro pasa-bajos RC

Fig. 15. Ampliacion de gr ´ | aficos Filtro pasa-bajos RC ´

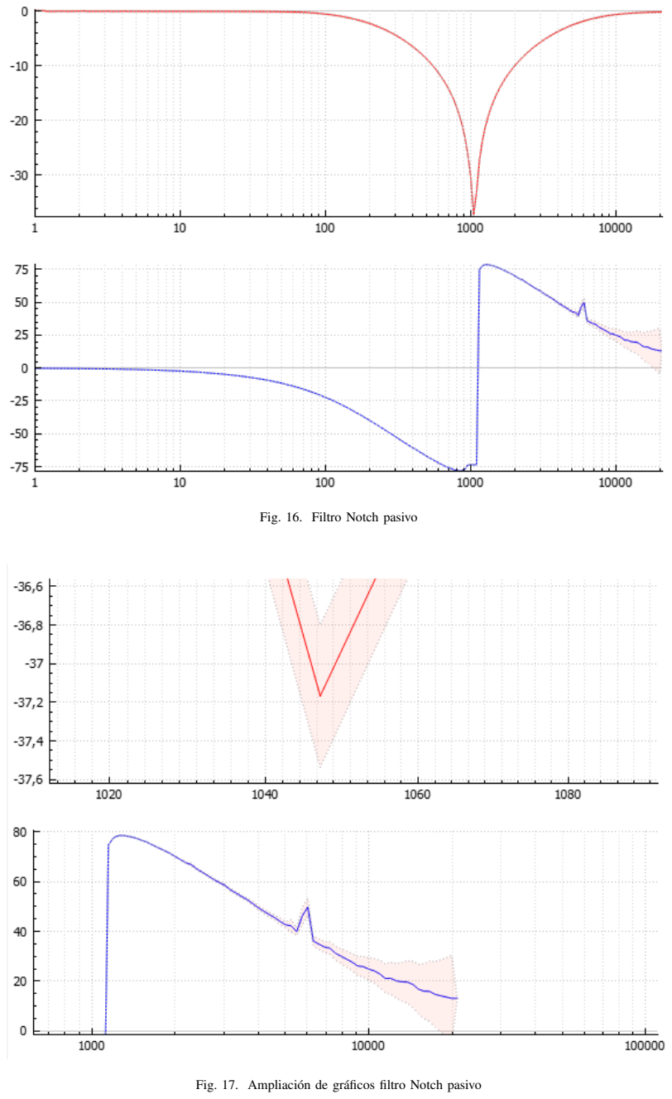
[picture p17: page 13]

Fig. 16. Filtro Notch pasivo

Fig. 17. Ampliacion de gr ´ | aficos filtro Notch pasivo ´

X. CONCLUSIONES
A. Resultados
Los resultados obtenidos del calculo de incertidumbre re- ´ flejan que el dispositivo es suficientemente preciso y que no hay casi dispersiones en las curvas medidas. Sin embargo,
a frecuencias mas altas cercanas al l ´ | ímite del dispositivo,
se puede observar como aumenta la incertidumbre en la
fase debido a que la calibracion tiene una limitaci ´ | on en la ´
resolucion del intervalo de tiempo, la cual es de 1ns. El estudio ´ tipo A hecho mostro que la incertidumbre es casi despreciable ´
en comparacion a la que introduce el frecuenc ´ | ímetro utilizado
a esas frecuencias.
Para la incertidumbre que muestra el modulo, ocurre algo ´ similar a la fase en cuanto a que aumenta la incertidumbre
pero cuando la senal a medir es peque ˜ | na. En este caso la ˜
incertidumbre la aporta casi toda la tipo A debido a que el
dispositivo intenta medir senales que est ˜ | an cercanas al piso ´
de ruido del sistema, por lo que aumenta la variacion en las ´ cuentas que arroja el ADC del MCU debido a este efecto; por lo tanto aumenta la incertidumbre tipo A.
B. Limitaciones
El ancho de banda resulto ser mucho menor al esperado ´ antes de realizar el proyecto. Por un lado porque para la
medicion de m ´ | odulo se opt ´ | o por un circuito detector de pico ´
con bajo nivel de ruido y que mida tensiones bajas en el orden de los milivolts a otro con buena respuesta en frecuencia pero con mayor nivel de ruido y por ende menor precision. ´ Por otro lado, al medir la fase, si bien los comparadores funcionan perfectamente hasta 1MHz, el input capture deja de detectar los flancos de las senales cuadradas una vez ˜ superados aproximadamente los 25kHz (por eso el límite a 20kHz dejando un margen de seguridad).
Otro problema, mencionado en la seccion de rangos, tiene ´ que ver con la medicion de amplitud a baja frecuencia y baja ´ amplitud debido que el ripple de descarga de los capacitores de los detectores de pico se vuelve considerable.
La medicion se torna ciertamente lenta, ya que le toma 1 ´ segundo a los capacitores de los detectores de pico para descargarse y cargarse nuevamente a la tension correspondiente, por ´
lo que para una medicion con mucha resoluci ´ | on en frecuencia ´
(muchos puntos), puede tardar hasta casi 10 minutos en medir.
C. Posibles Mejoras
Una forma de mejorar sustancialmente el sistema es utilizando un microcontrolador con un ADC mas r ´ apido para ´ poder muestrear la senal, y con mayor frecuencia de clock ˜ para poder realizar un algoritmo de Goertzel [13], el cual se puede tomar como una transformada de rapida Fourier pero ´
que solo devuelve un n ´ | umero complejo correspondiente al bin ´
de una frecuencia específica, la cual sería configurada para que sea la frecuencia que generamos con el DDS. De esta manera se puede reducir el hardware al maximo, retirando ´ los detectores de pico y los comparadores, y no depender del input capture del timer interno del microcontrolador. Esto tiene como consecuencia una mejora en la exactitud de la medicion´

(al evitar errores y limitaciones del hardware adicional), en el ancho de banda, ya que solo depende de la velocidad del ADC y de procesamiento del microcontrolador, y en el tiempo de medicion dado que no hay que esperar a que se descarguen y ´ se carguen los capacitores de los detectores de pico.
Una mejora a este ultimo sistema mencionado ser ´ | ía realizar
un barrido en frecuencia casi instantaneo componiendo un ´ espectro de agujas, centradas en las frecuencias de interes, y ´ luego obtener una senal asociada este espectro mediante una ˜
transformada rapida de Fourier inversa. Esta ser ´ | ía la senal que ˜
excitaría al filtro a analizar. Luego a la senal filtrada se le aplica ˜ una transformada rapida de Fourier para analizar de forma ´ simultanea como se modificaron las agujas en el espectro de ´ salida.

REFERENCES

[1] REDPITAYA, “Bode analyzer,” Disponible en https://redpitaya.com/applications-measurement-tool/bode-analyzer/. (https://redpitaya.com/applications-measurement-tool/bode-analyzer/)
[2] O. LAB, “Bode 100,” Disponible en https://www.omicron-lab.com/products/vector-network-analysis/bode-100#. (https://www.omicron-lab.com/products/vector-network-analysis/bode-100#)
[3] STM, “Touchgfx documentation,” Disponible en https://support.touchgfx.com/4.21/docs/introduction/welcome. (https://support.touchgfx.com/4.21/docs/introduction/welcome)
[4] ——, “Stm32f401xb/c and stm32f401xd/e advanced arm®-based 32-bit
mcus,” Disponible en https://www.st.com/resource/en/reference manual/ rm0368-stm32f401xbc-and-stm32f401xde-advanced-armbased-32bit-mcus-stmicroelectronics. pdf (https://www.st.com/resource/en/reference_manual/rm0368-stm32f401xbc-and-stm32f401xde-advanced-armbased-32bit-mcus-stmicroelectronics.pdf) (19/12/18).
[5] ——, | “Stm32 | nucleo-64 | boards | (mb1136),” | Disponible
en | https://www.st.com/resource/en/user manual/
um1724-stm32-nucleo64-boards-mb1136-stmicroelectronics.pdf (https://www.st.com/resource/en/user_manual/um1724-stm32-nucleo64-boards-mb1136-stmicroelectronics.pdf) (20/08/20).
[6] ILITEK, “a-si tft lcd single chip driver 240rgbx320 resolution and 262k color,” Disponible en https://cdn-shop.adafruit.com/datasheets/ILI9341. pdf. (https://cdn-shop.adafruit.com/datasheets/ILI9341.pdf)
[7] A. Devices, “Low power, 12.65 mw, 2.3 v to 5.5 v, programmable waveform generator,” Disponible en https://www.analog.com/media/en/technical-documentation/data-sheets/ad9833.pdf (https://www.analog.com/media/en/technical-documentation/data-sheets/ad9833.pdf) (04/19).
[8] T. Instruments, “Lm111, lm211, lm311 differential comparators,” Disponible en https://www.ti.com/lit/ds/symlink/lm311.pdf(03/17).
[9] ——, “Fet-input, low distortion operational amplifier,” Disponible en https://www.ti.com/general/docs/suppproductinfo.tsp?distId=26&gotoUrl=https://www.ti.com/lit/gpn/opa604 (https://www.ti.com/general/docs/suppproductinfo.tsp?distId=26&gotoUrl=https://www.ti.com/lit/gpn/opa604) (09/03).
[10] RIGOL, “Arbitrary waveform generator specifications,” Disponible en https://beyondmeasure.rigoltech.com/acton/attachment/1579/f-0051/0/-/-/-/-/file.pdf. (https://beyondmeasure.rigoltech.com/acton/attachment/1579/f-0051/0/-/-/-/-/file.pdf)
[11] PROTEK, “Frequency counter specifications,” Disponible en http://www.arivigevano.net/files/pk9100.pdf.
[12] AGILENT, | “Waveform | generator | specifications,” | Disponible
en | https://electricayelectronica.uniandes.edu.co/sites/default/files/
laboratorios/manual-33500-Op-and-Svc-US.pdf. (https://electricayelectronica.uniandes.edu.co/sites/default/files/laboratorios/manual-33500-Op-and-Svc-US.pdf)
[13] WIKIPEDIA, “Goertzel algorithm,” Disponible en https://en.wikipedia.org/wiki/Goertzel algorithm(24/01/2023). (https://en.wikipedia.org/wiki/Goertzel_algorithm)
