AleNimo/Bode_Analyzer/Imagenes Manuales/Schematic_Nucleo_power.png

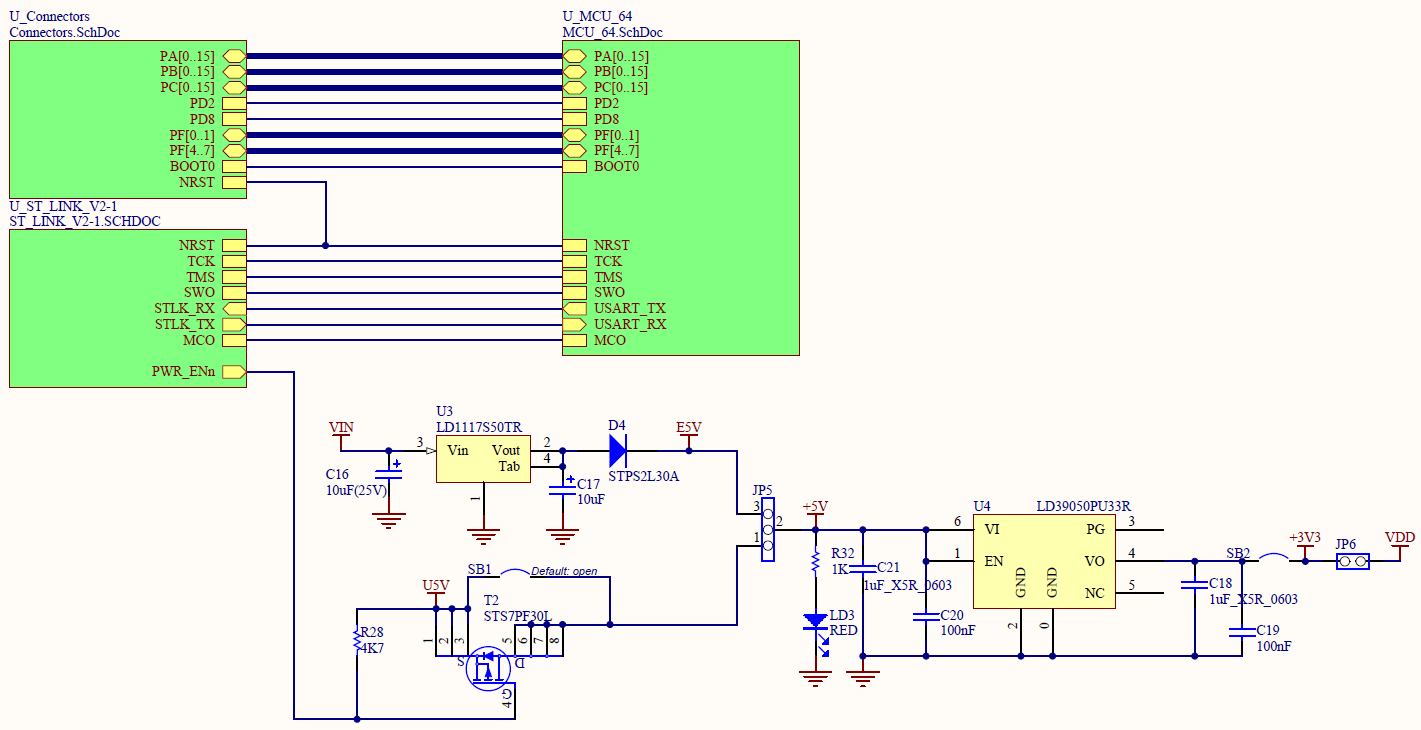
Imagenes Manuales/Schematic_Nucleo_power.png
