AleNimo/Bode_Analyzer/Imagenes Paper/ADC_raw.png

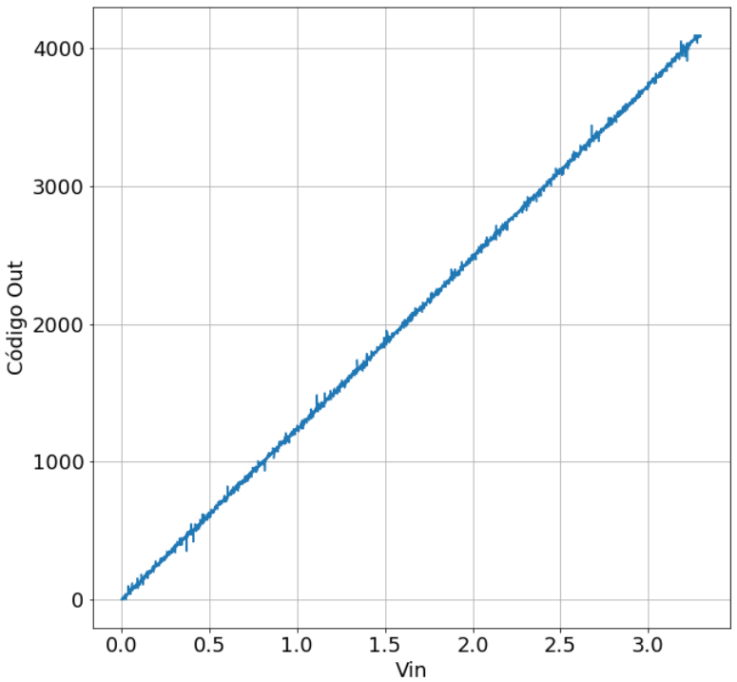
Imagenes Paper/ADC_raw.png
