AleNimo/Bode_Analyzer/Imagenes Paper/Bode Analyzer - FlowChart.png

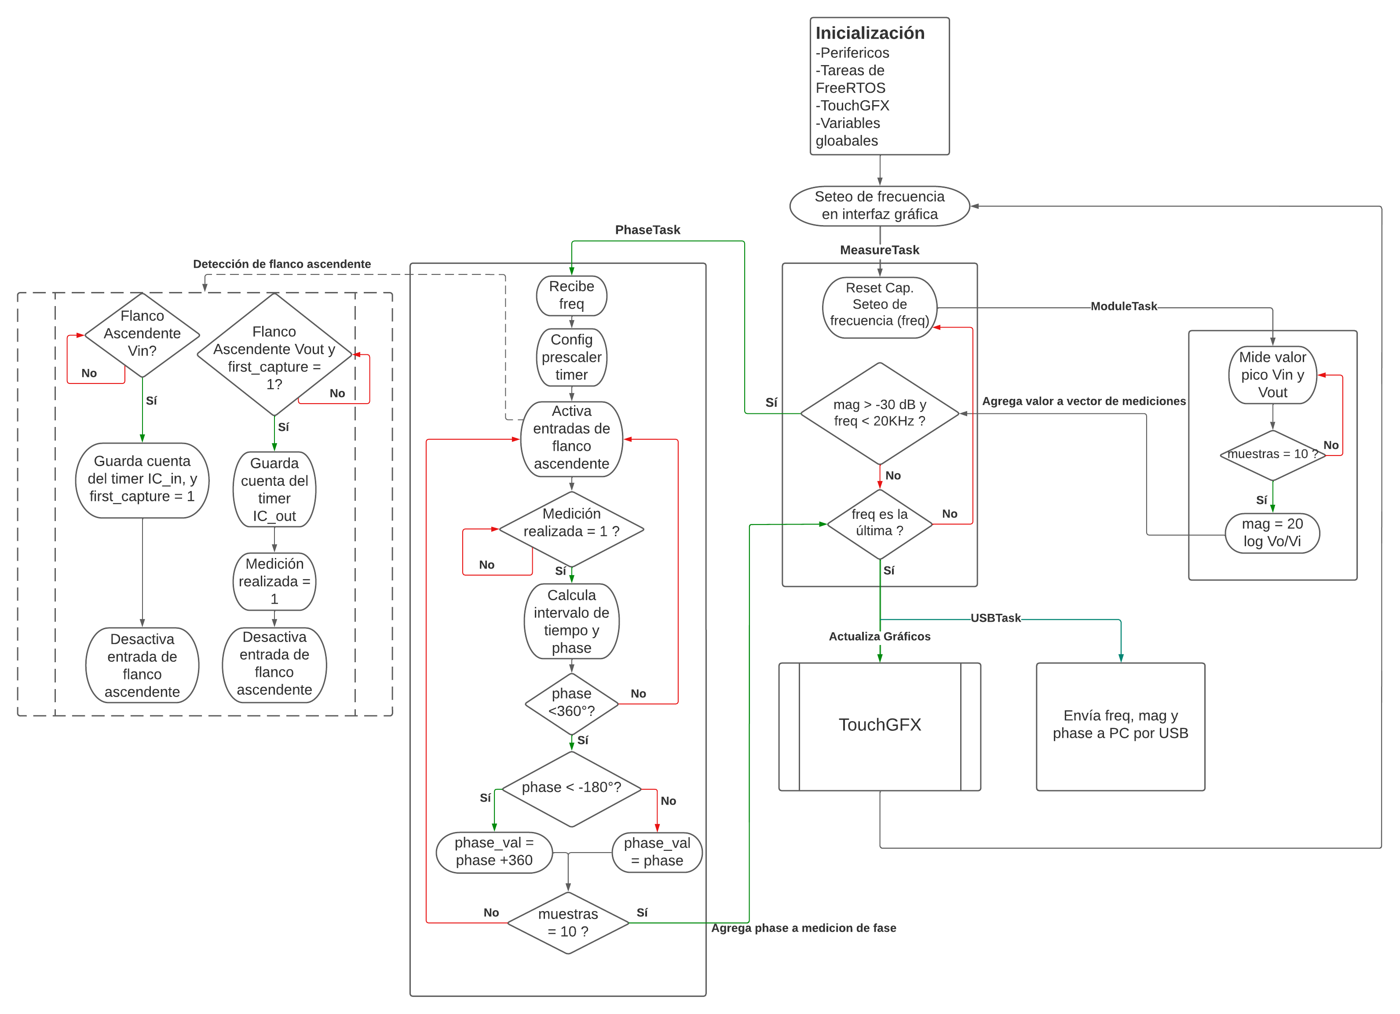
Imagenes Paper/Bode Analyzer - FlowChart.png
