AleNimo/Bode_Analyzer/Imagenes Paper/Bode con incertidumbre y zoom.png

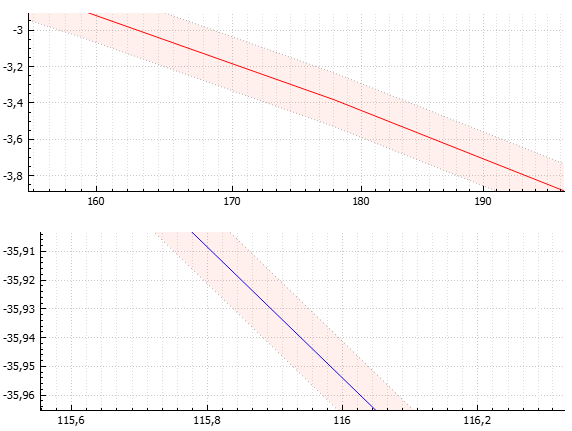
Imagenes Paper/Bode con incertidumbre y zoom.png
