AleNimo/Bode_Analyzer/Imagenes Paper/Bode con incertidumbre.png

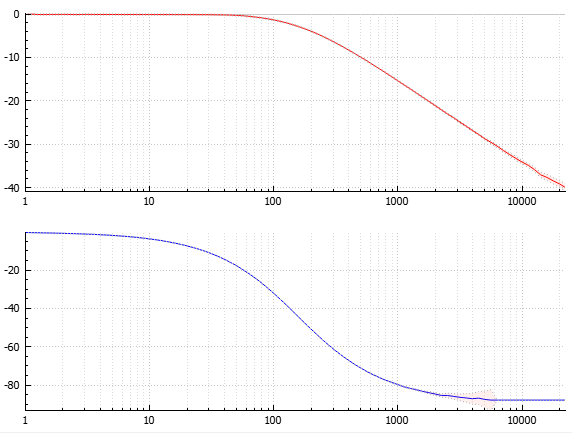
Imagenes Paper/Bode con incertidumbre.png
