AleNimo/Bode_Analyzer/Imagenes Paper/bode_notch.png

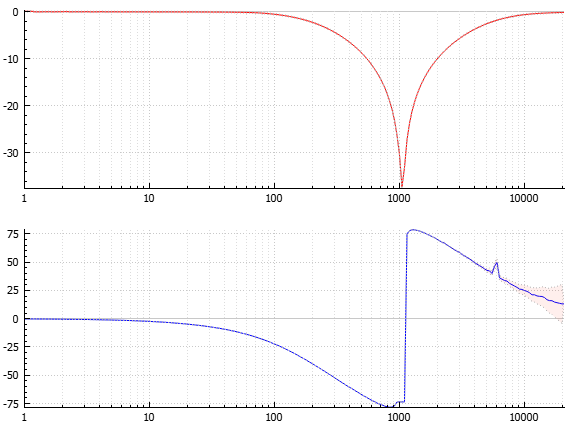
Imagenes Paper/bode_notch.png
