AleNimo/Bode_Analyzer/Imagenes Paper/bode_notch_zoom.png

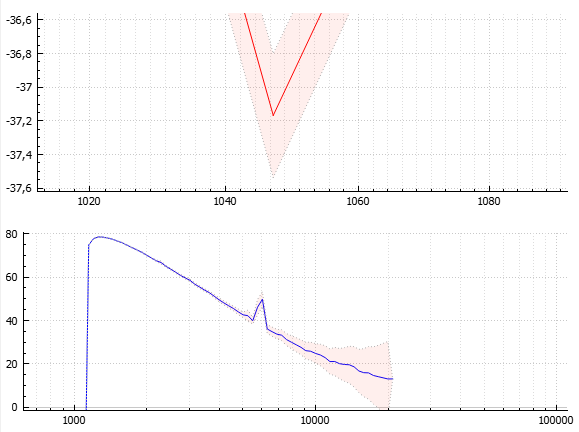
Imagenes Paper/bode_notch_zoom.png
