AleNimo/Bode_Analyzer/Imagenes Paper/Diagrama en bloques cualitativo.png

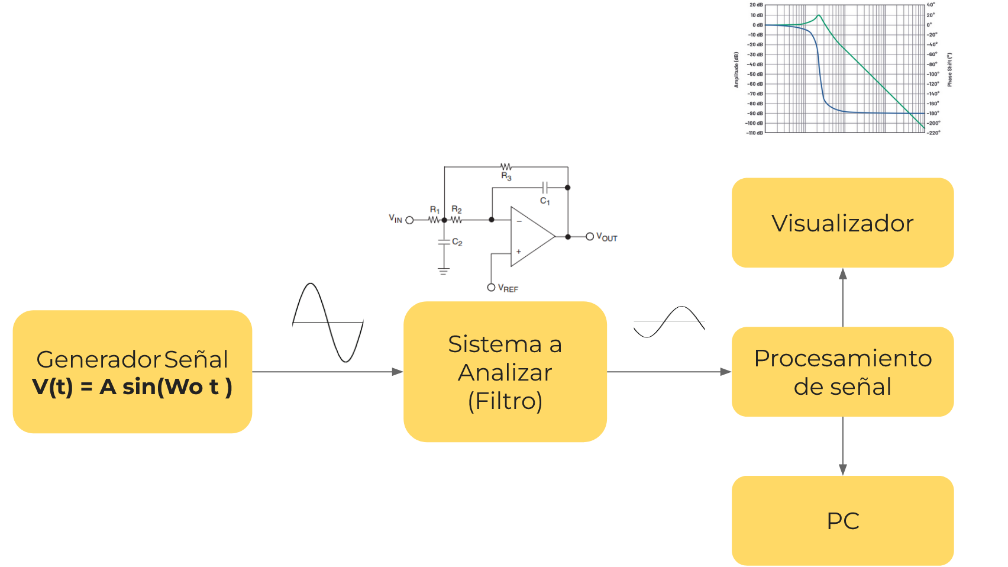
Imagenes Paper/Diagrama en bloques cualitativo.png
