AleNimo/Bode_Analyzer/Imagenes Paper/Diagrama en bloques detallado.png

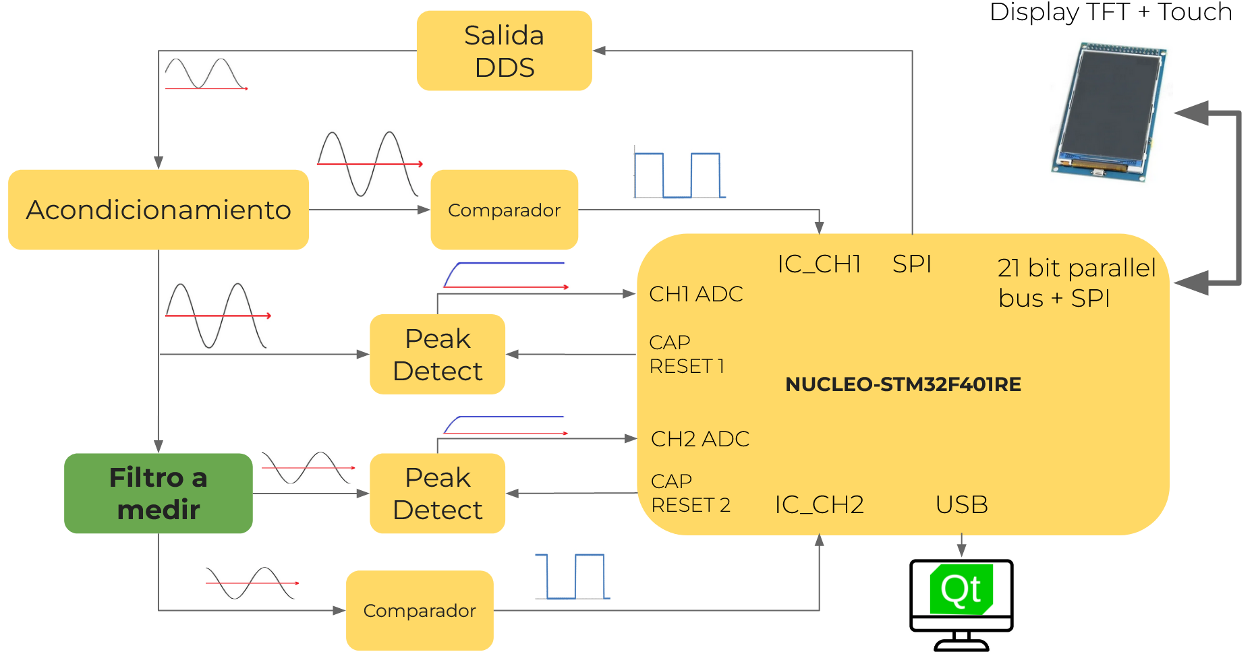
Imagenes Paper/Diagrama en bloques detallado.png
