AleNimo/Bode_Analyzer/Imagenes Paper/Screen_GraphMAG.PNG

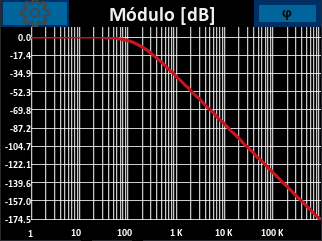
Imagenes Paper/Screen_GraphMAG.PNG
