AleNimo/Bode_Analyzer/Paints/Calculo de preescaler.png

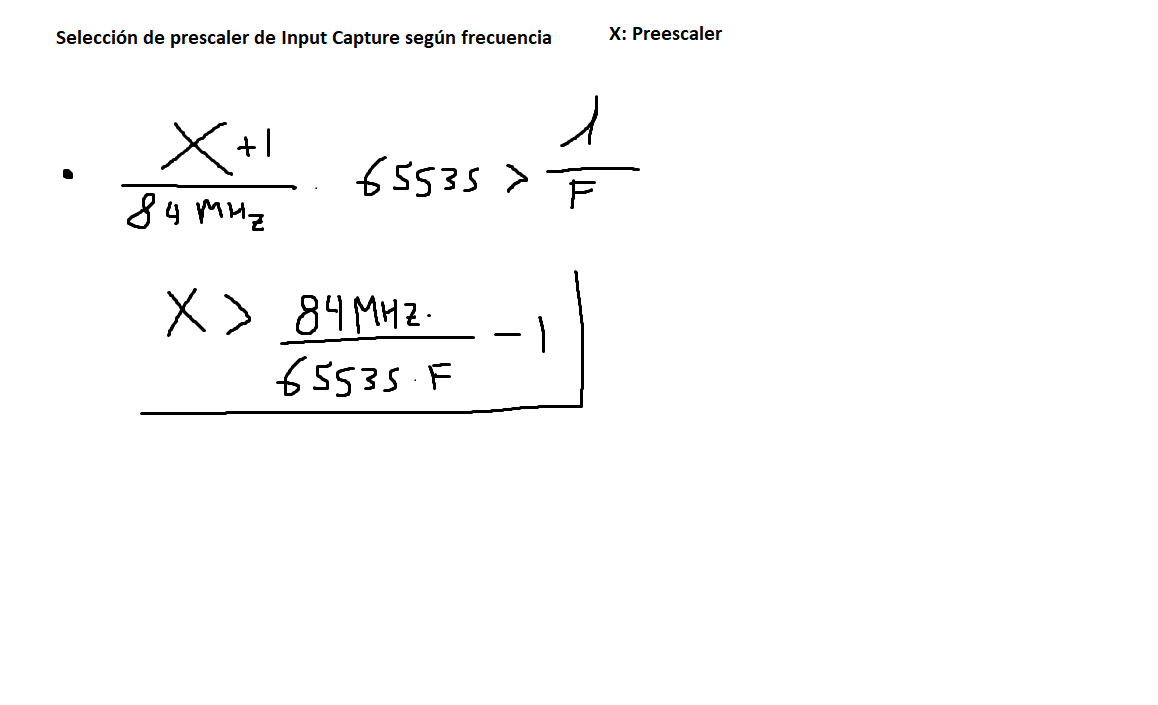
Paints/Calculo de preescaler.png
