AleNimo/Bode_Analyzer/Paints/Diagrama codigo.png

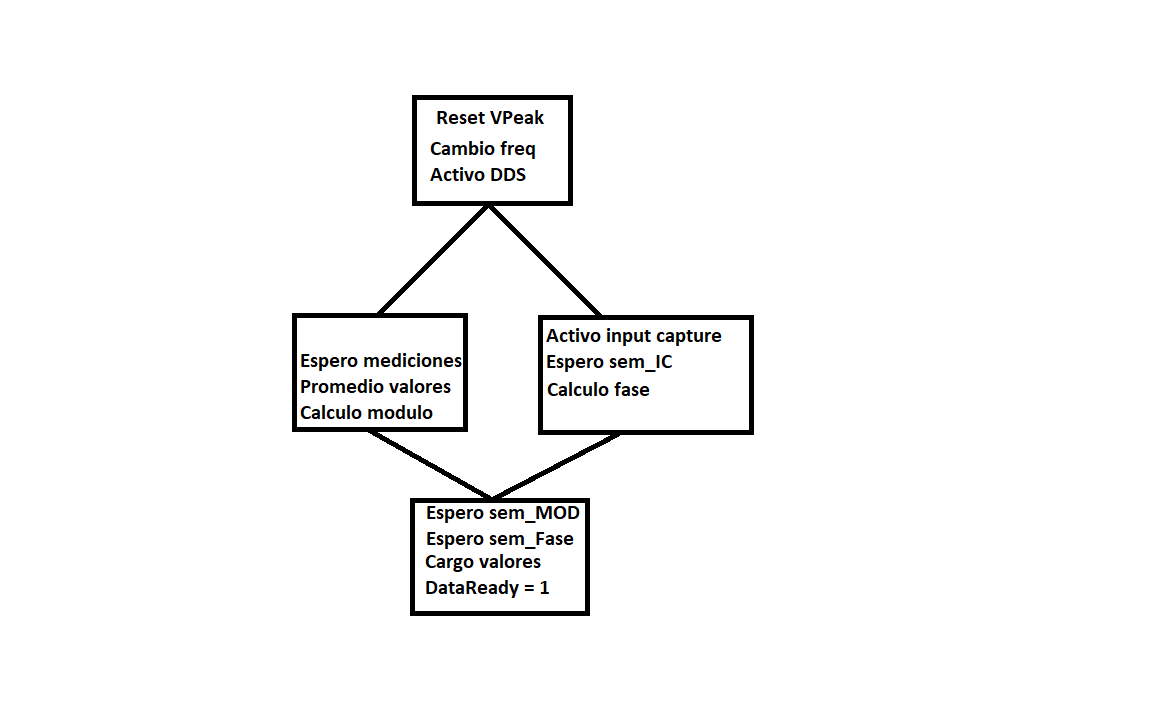
Paints/Diagrama codigo.png
