AleNimo/Bode_Analyzer/Paints/Generacion de vector de frecuencia.png

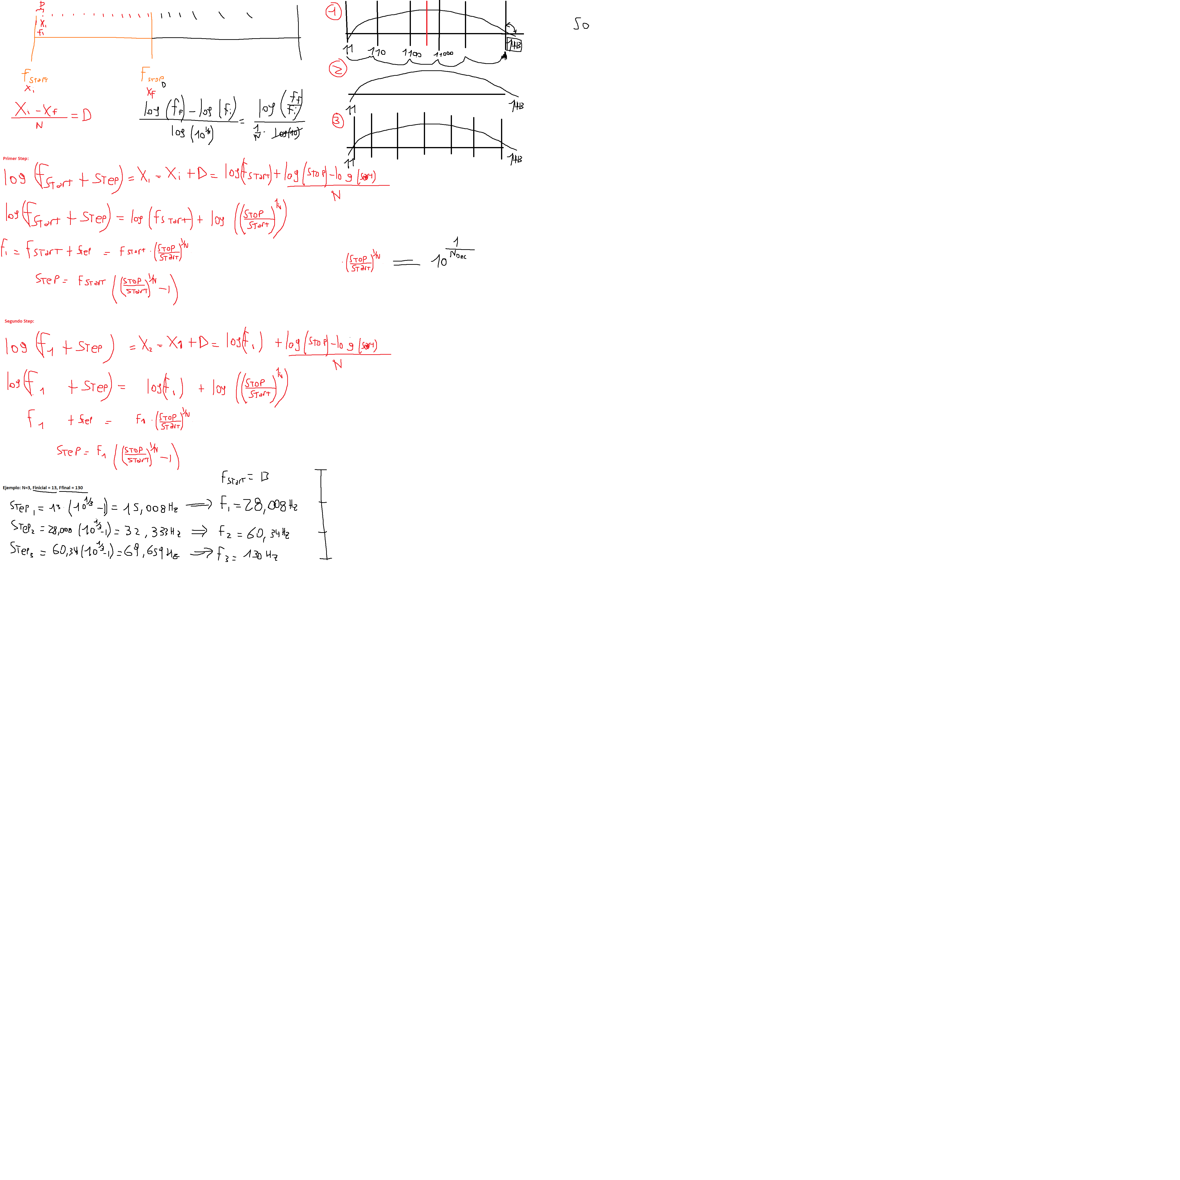
Paints/Generacion de vector de frecuencia.png
