AleNimo/Bode_Analyzer/Paints/Incertidumbre.png

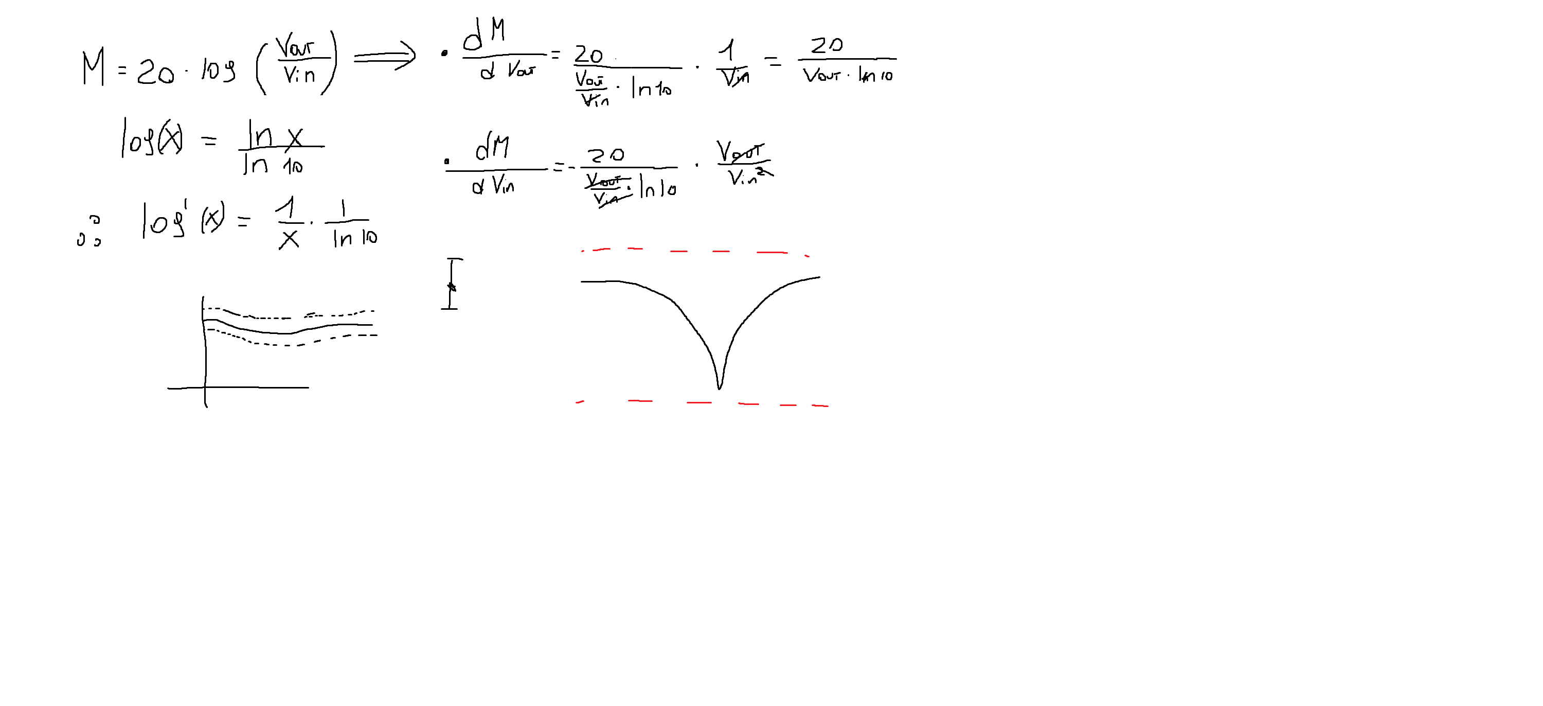
Paints/Incertidumbre.png
