AleNimo/Bode_Analyzer/Paints/Interpolación.png

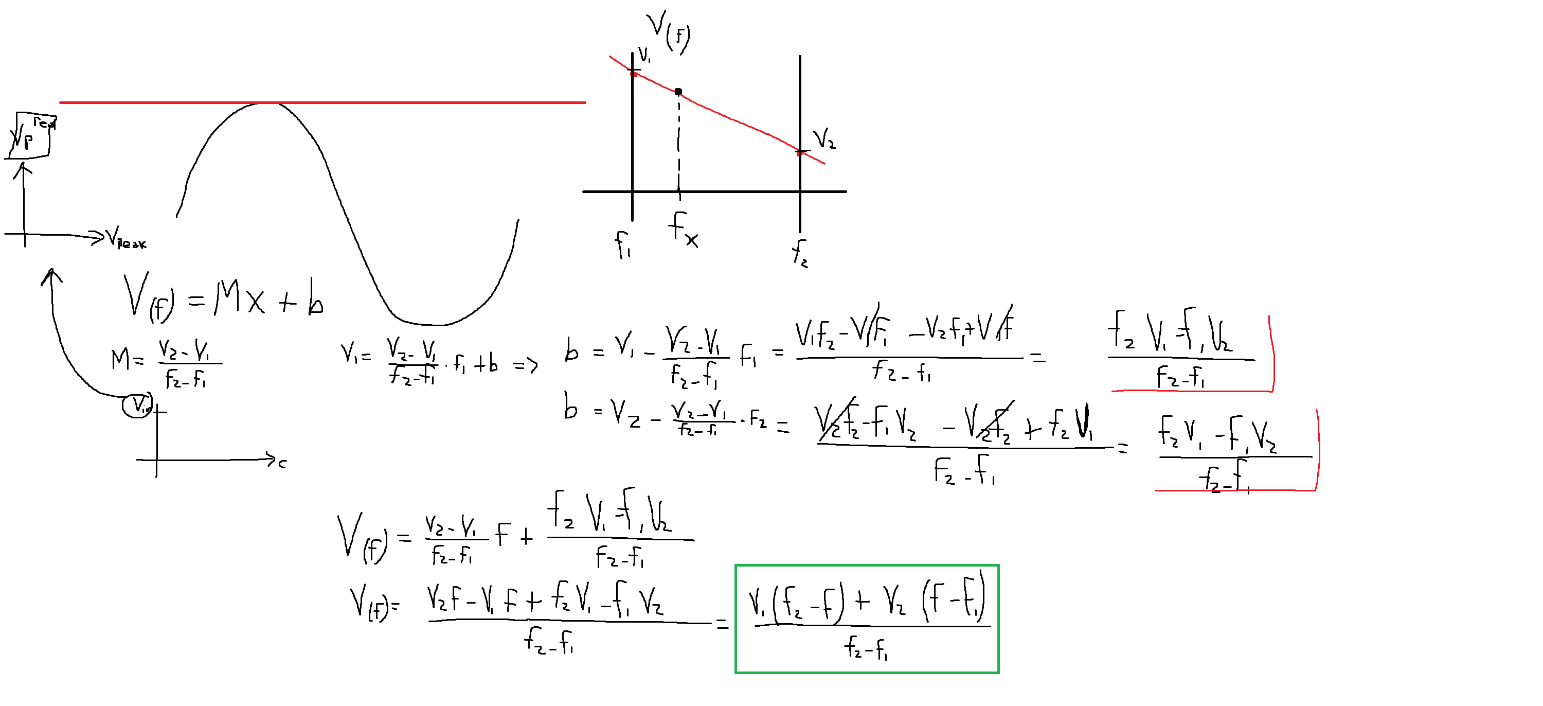
Paints/Interpolación.png
