AleNimo/Bode_Analyzer/Paints/Medicion de fase.png

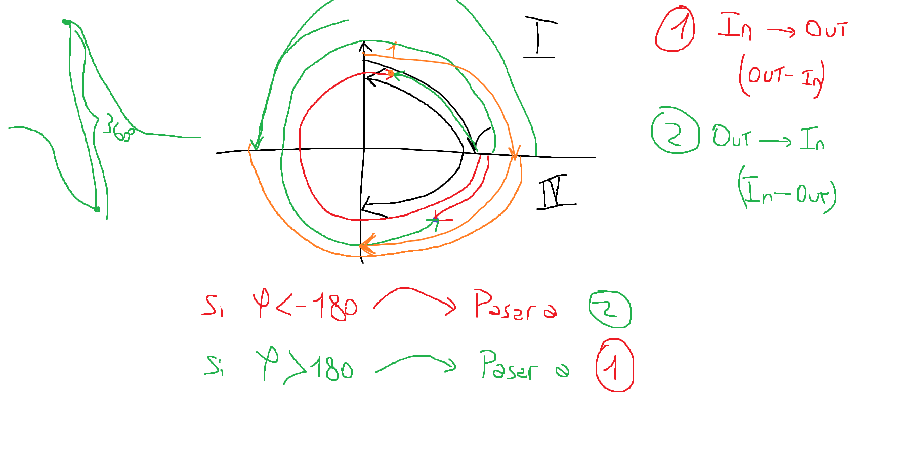
Paints/Medicion de fase.png
