AleNimo/Bode_Analyzer/Paints/Medicion Fase.png

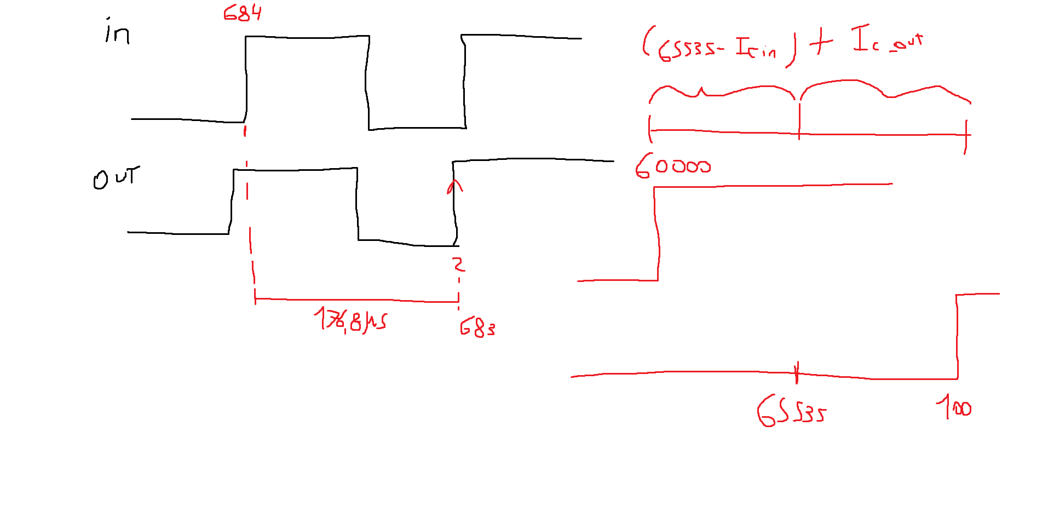
Paints/Medicion Fase.png
