AleNimo/Bode_Analyzer/Bode_Analyzer/Bode_Analyzer.xlsx

Comment | Description | Designator | Footprint | LibRef | Quantity | Manufacturer | Manufacturer Part Number | Supplier 1 | Supplier Part Number 1
100nF | CAP0805 100nF X7R | C1, C2, C8, C9, C10, C12, C13, C17, C20, C21, C24, C25, C28, C32, C33, C35, C36, C37, C40, C41 | 0805 | CAP0805_100nF_X7R | 20
10uF 16V | CAP TANT 10UF 10% 16V RADIAL | C3 | CAP318 | CAP_TAN_10uF_16V_CAP318 | 1 | KYOCERA AVX | TAP106K016CRS | Digi-Key | 478-TAP106K016CRSCT-ND
10uF 16V | CAP0805 10uF 16V X5R | C4, C5, C6, C7, C11, C14, C15, C16, C18, C19, C26, C27, C29, C30, C31, C34 | 0805 | CAP0805_10uF_16V_X5R | 16 | TDK Corporation | C2012X5R1C106K085AC | Digi-Key | 445-7644-1-ND
220nF | CAP CER RAD 220NF 250V C0G 10% | C23 | CAP508 | CAP_CER_100nF_250V_CAP508 | 1 |  |  | Digi-Key
100nF | CAP CER RAD 100NF 250V C0G 10% | C22 | CAP508 | CAP_CER_100nF_250V_CAP508 | 1 |  |  | Digi-Key
220uF 25V | CAP ELECT 220uF 25V | C38, C39 | CAP300RP | CAP_ELECT_220uF_25V | 2 | Nichicon | UVR1E221MPD1TA | Digi-Key | 493-6097-3-ND
1N4148WS | DIODE 75V 150MA SOD323F | D1, D2 | SOD323F | 1N4148_SOD323F | 2 |  |  | Digi-Key | 1N4148WSFSTR-ND
RECEPTACULO 7POS 0.1" | RECEPTACULO 1x7 POS 0.1" | J1 | SIPF7 | RECEPTACLE_7POS_0.1" | 1 |  |  | ElectroComponentes
MINIUSB_FEMALE_SMD | CONECTOR MINIUSB FEMALE_SMD | J2 | USB_MINI_FEMALE | CON_MINIUSB_FEMALE_SMD | 1 |  |  | ElectroComponentes
BNC | CONN BNC RCPT STR 50 OHM PCB | J3, J4 | BNC | BNC | 2 | Amphenol RF | 112404 | Digi-Key | ACX1051-ND | https://www.sycelectronica.com.ar/articulo.php?codigo=B-7038
JUMPER3 | TIRA DE PINES 1x3 0.1" + JUMPER | J5 | JUMPER3 | JUMPER3_TH | 1 | Harwin Inc. | M20-9990345 | Digi-Key | 952-2263-ND
ILI9341 | ILI9341-3.2'' | J6 | ILI9341 | ILI9341-3.2 | 1
1984620 | TERM BLK 3P SIDE ENT 3.5MM PCB | J7 | BORNERA3_3.5MM | BORNERA_3_3.5MM_TORNILLO | 1 | Phoenix Contact | 1984620 | Digi-Key | 277-1722-ND
100K 1% | RES0805 100K 1% | R1, R6, R7, R8, R11 | 0805 | RES0805_100K_1% | 3 | Stackpole Electronics Inc | RMCF0805FG100K | Digi-Key | RMCF0805FG100KCT-ND
1K 1% 1/4W | RES SMD 1K OHM 1% 1/4W 0805 | R2, R5, R10 | 0805 | RES0805_1K_1% | 3 | Stackpole Electronics Inc | RNCP0805FTD1K00 | Digi-Key | RNCP0805FTD1K00TR-ND
20K | 3296 TRIMMER 20K OHM 0.5W PC PIN | R3 | 3296W-TOP | TRIMMER_3296W_20K | 1 | Bourns Inc. | 3296W-1-203 | Digi-Key | 3296W-203-ND | https://www.sycelectronica.com.ar/articulo.php?codigo=3296W-20K
100K | 3296 TRIMMER 100K OHM 0.5W PC PIN | R4 | 3296W-TOP | TRIMMER_3296W_100K_MULTI | 1 | Bourns Inc. | 3296W-1-104LF | Digi-Key | 3296W-104LF-ND
680R | RES0805 680R 1% | R9, R12 | 0805 | RES0805_680R_1% | 2 | Stackpole Electronics Inc | RMCF0805FT680R | Digi-Key | RMCF0805FT680RCT-ND
NUCLEO-F401RE | NUCLEO-F401RE | U1 | NUCLEO-F401RE | NUCLEO-F401RE | 1 | STMicroelectronics | NUCLEO-F401RE | Digi-Key
OPA604APG4 | IC OPAMP GP 1 CIRCUIT 8DIP | U2, U3, U7, U8 | DIP8 | OPA604APG4 | 4 | Texas Instruments | OPA604APG4 | Digi-Key | OPA604APG4-ND
LM311M | IC VOLTAGE COMPARATOR 8-SOIC | U4, U5, U6, U9 | DIP8 | LM311N | 4 |  |  | Digi-Key | LM311MNS/NOPB-ND
7809 | IC REG LDO 9V 1.5A TO220 | U10 | TO220-V | 7809 | 1 |  |  | ElectroComponentes
7909 | IC REG LDO -9V 1.5A TO220 | U11 | TO220-V | 7909 | 1 |  |  | ElectroComponentes
2N7000_TO92 | MOSFET N-CH 60V 200MA TO-92 | Q1, Q2 | TO92_DGS | MOSFET N | 2
4K7 | RES0805 4K7 5% | R13, R14 | 0805 | RES0805_4K7_5% | 2 | Stackpole Electronics Inc | RMCF0805JT4K70 | Digi-Key | RMCF0805JT4K70TR-ND
