AleNimo/Bode_Analyzer/Imagenes Manuales/App_Conectar.png

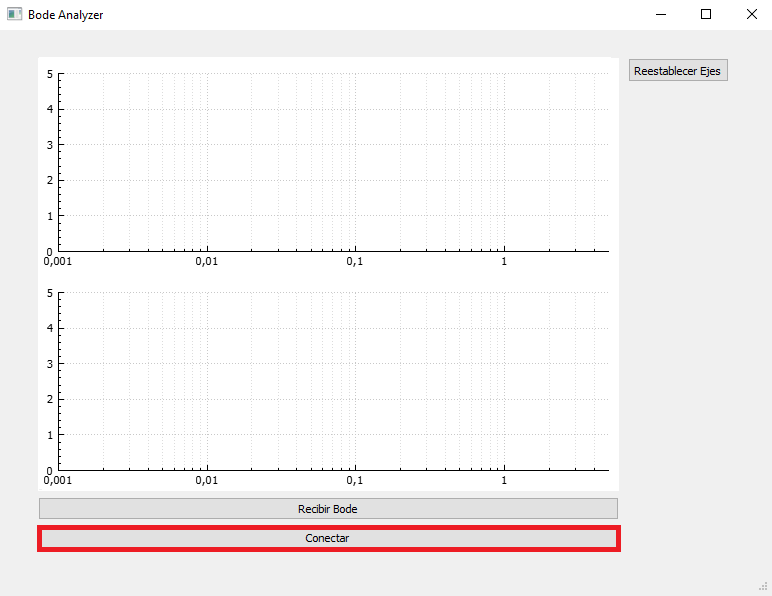
Imagenes Manuales/App_Conectar.png
