AleNimo/Bode_Analyzer/Imagenes Manuales/App_graficos.png

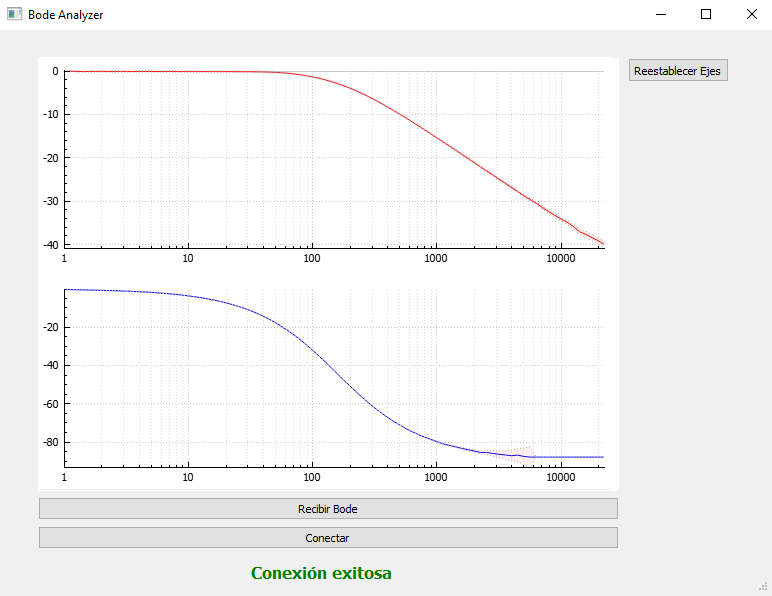
Imagenes Manuales/App_graficos.png
