AleNimo/Bode_Analyzer/Imagenes Manuales/App_graficos_zoom.png

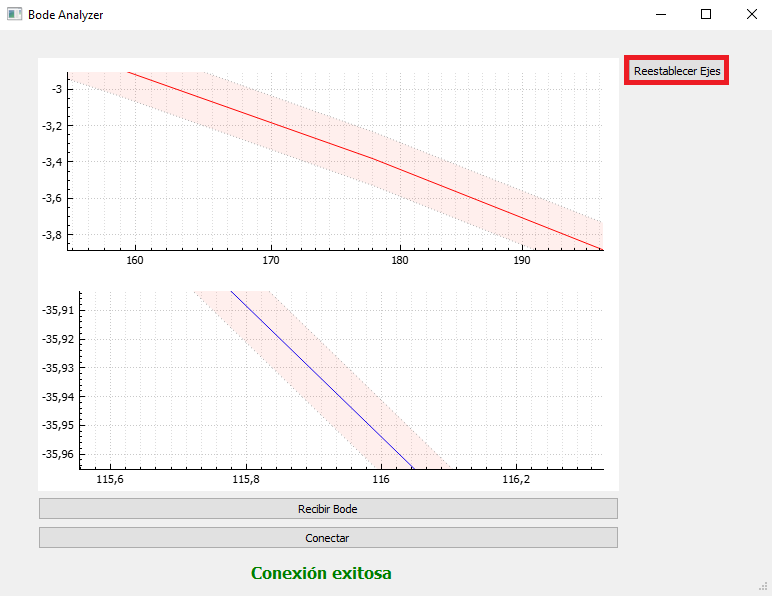
Imagenes Manuales/App_graficos_zoom.png
