AleNimo/Bode_Analyzer/Imagenes Manuales/Foto_BodeAnalyzer.jpg

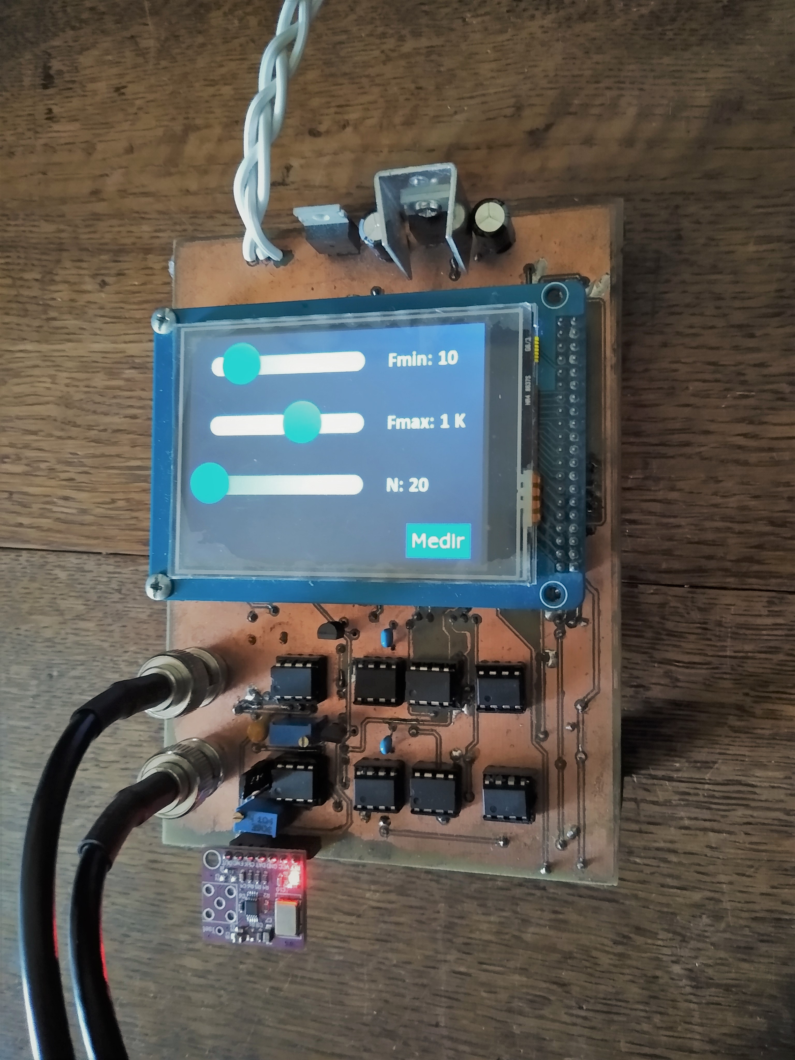
Imagenes Manuales/Foto_BodeAnalyzer.jpg
