AleNimo/Bode_Analyzer/Imagenes Manuales/Nucleo_en_PCB.png

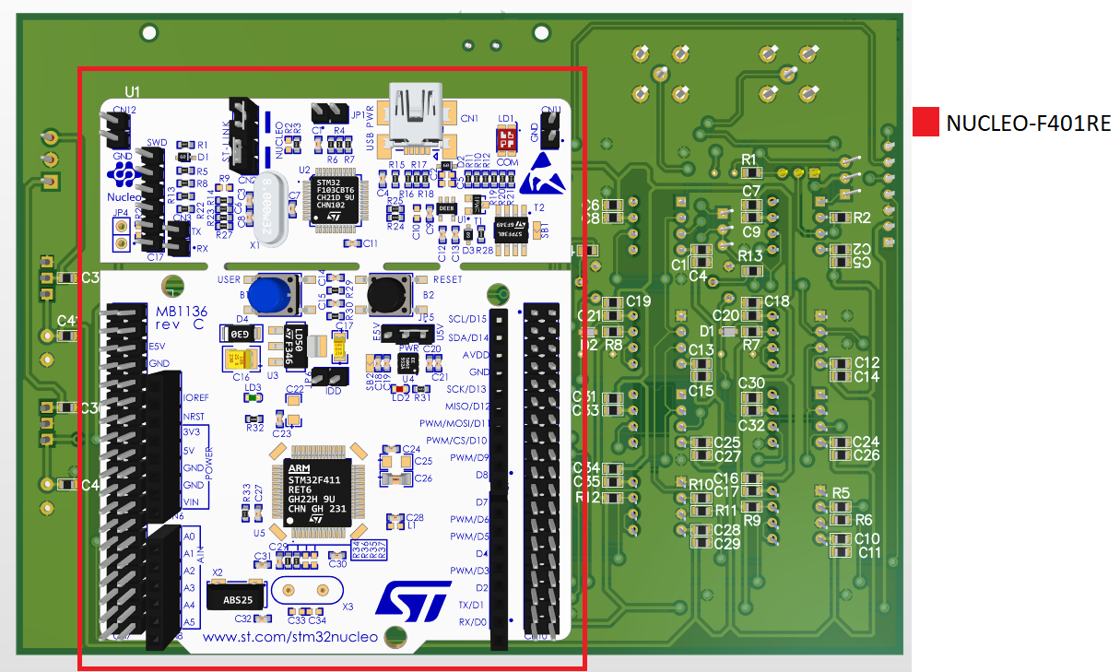
Imagenes Manuales/Nucleo_en_PCB.png
