AleNimo/Bode_Analyzer/Imagenes Manuales/Pantalla_Barra.png

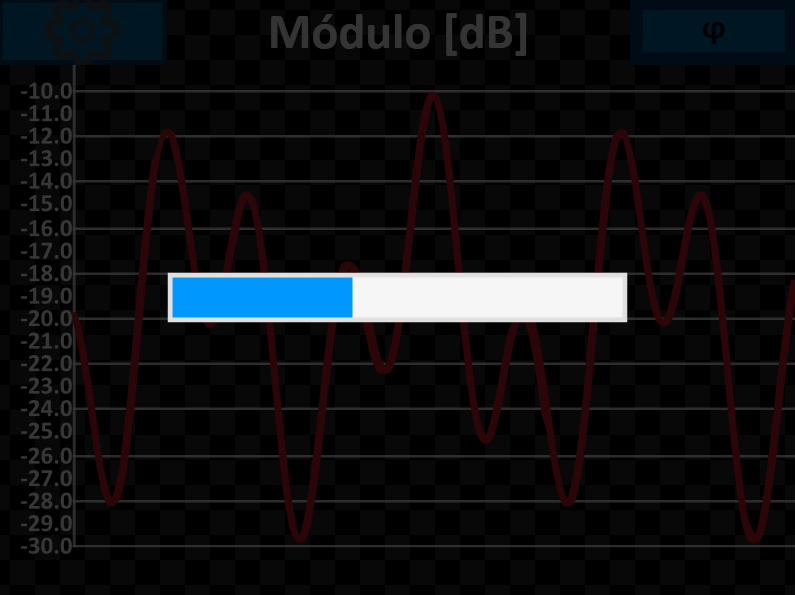
Imagenes Manuales/Pantalla_Barra.png
