AleNimo/Bode_Analyzer/Imagenes Manuales/USB_Placa.jpg

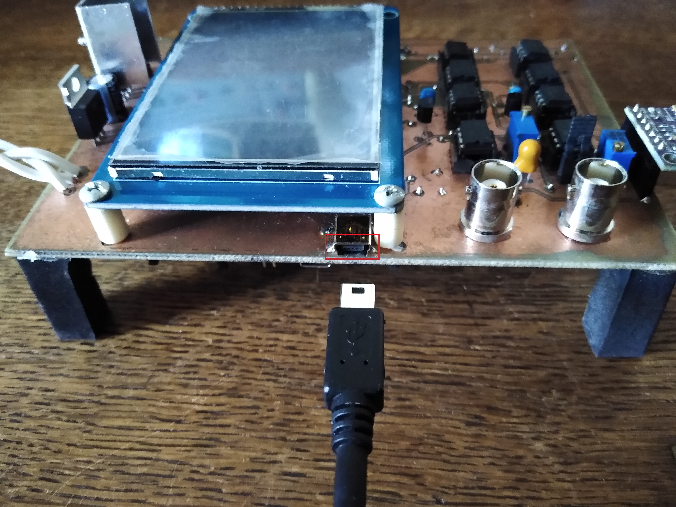
Imagenes Manuales/USB_Placa.jpg
