AleNimo/Bode_Analyzer/Calibracion/Ensayo de distorsión armónica/Oscilogramas THD/TEK0001.CSV

Record Length | 2.500000e+03 | 0.000000000000 | -5.12000
Sample Interval | 1.000000e-02 | 0.010000000000 | -5.12000
Trigger Point | 0.000000000000e+00 | 0.020000000000 | -5.12000
 |  | 0.030000000000 | -5.12000
 |  | 0.040000000000 | -5.12000
 |  | 0.050000000000 | -5.12000
Source | CH1 | 0.060000000000 | -5.12000
Vertical Units | V | 0.070000000000 | -5.12000
Vertical Scale | 1.000000e+00 | 0.080000000000 | -5.12000
Vertical Offset | 0.000000e+00 | 0.090000000000 | -5.12000
Horizontal Units | s | 0.100000000000 | -5.12000
Horizontal Scale | 2.500000e+00 | 0.110000000000 | -5.12000
Pt Fmt | Y | 0.120000000000 | -5.12000
Yzero | 0.000000e+00 | 0.130000000000 | -5.12000
Probe Atten | 1.000000e+00 | 0.140000000000 | -5.12000
Model Number | TDS2014C | 0.150000000000 | -5.12000
Serial Number | C013080 | 0.160000000000 | -5.12000
Firmware Version | FV:v24.15 | 0.170000000000 | -5.12000
 |  | 0.180000000000 | -5.12000
 |  | 0.190000000000 | -5.12000
 |  | 0.200000000000 | -5.12000
 |  | 0.210000000000 | -5.12000
 |  | 0.220000000000 | -5.12000
 |  | 0.230000000000 | -5.12000
 |  | 0.240000000000 | -5.12000
 |  | 0.250000000000 | -5.12000
 |  | 0.260000000000 | -5.12000
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
