AleNimo/Bode_Analyzer/Calibracion/Ensayo de distorsión armónica/Oscilogramas THD/TEK0003.CSV

Record Length | 2.500000e+03 | 0.000000000000 | -5.12000
Sample Interval | 4.000000e-03 | 0.004000000000 | -5.12000
Trigger Point | 0.000000000000e+00 | 0.008000000000 | -5.12000
 |  | 0.012000000000 | -5.12000
 |  | 0.016000000000 | -5.12000
 |  | 0.020000000000 | -5.12000
Source | CH1 | 0.024000000000 | -5.12000
Vertical Units | V | 0.028000000000 | -5.12000
Vertical Scale | 1.000000e+00 | 0.032000000000 | -5.12000
Vertical Offset | 0.000000e+00 | 0.036000000000 | -5.12000
Horizontal Units | s | 0.040000000000 | -5.12000
Horizontal Scale | 1.000000e+00 | 0.044000000000 | -5.12000
Pt Fmt | Y | 0.048000000000 | -5.12000
Yzero | 0.000000e+00 | 0.052000000000 | -5.12000
Probe Atten | 1.000000e+00 | 0.056000000000 | -5.12000
Model Number | TDS2014C | 0.060000000000 | -5.12000
Serial Number | C013080 | 0.064000000000 | -5.12000
Firmware Version | FV:v24.15 | 0.068000000000 | -5.12000
 |  | 0.072000000000 | -5.12000
 |  | 0.076000000000 | -5.12000
 |  | 0.080000000000 | -5.12000
 |  | 0.084000000000 | -5.12000
 |  | 0.088000000000 | -5.12000
 |  | 0.092000000000 | -5.12000
 |  | 0.096000000000 | -5.12000
 |  | 0.100000000000 | -5.12000
 |  | 0.104000000000 | -5.12000
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
