AleNimo/Bode_Analyzer/Paints/Calibracion timerIC.png

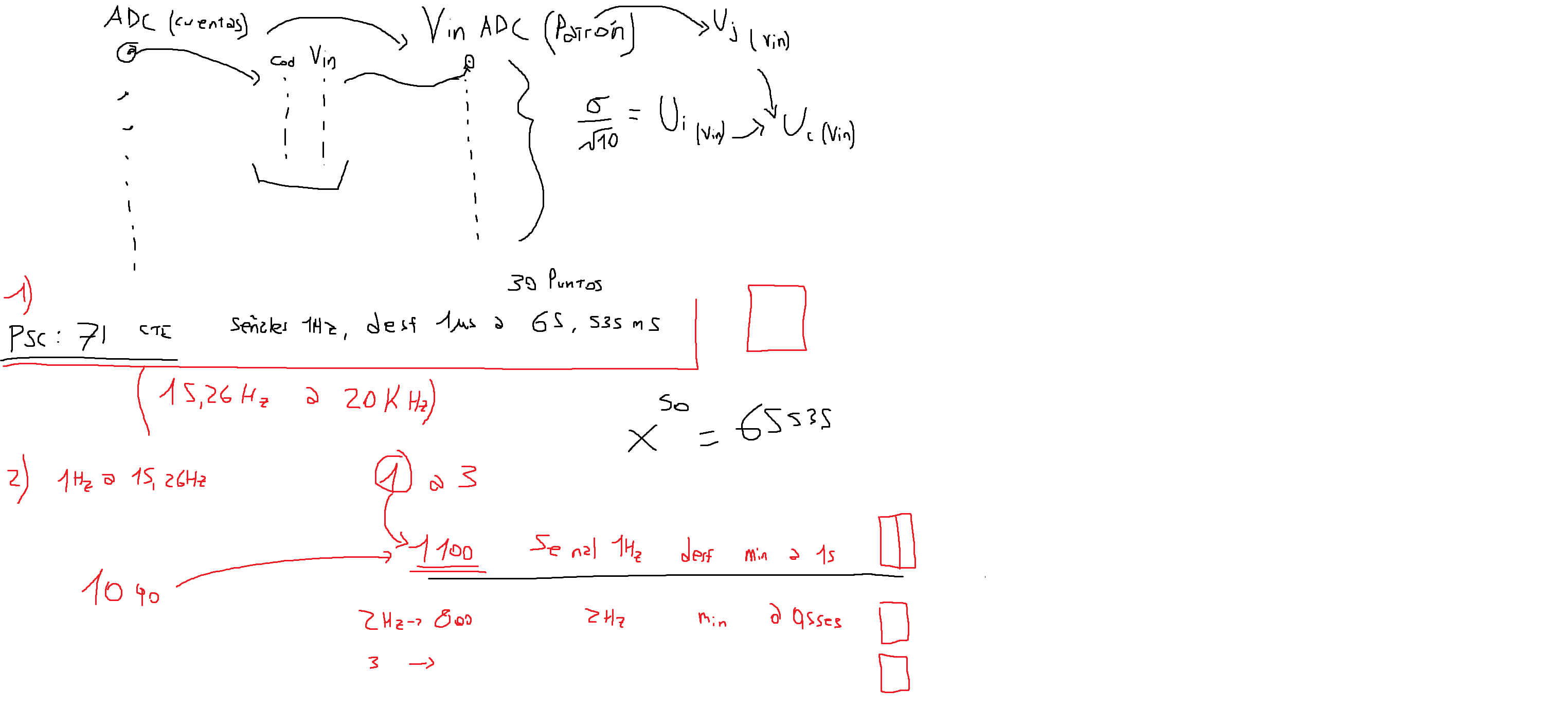
Paints/Calibracion timerIC.png
