AleNimo/Bode_Analyzer/Paints/Calibracion timerIC_2.png

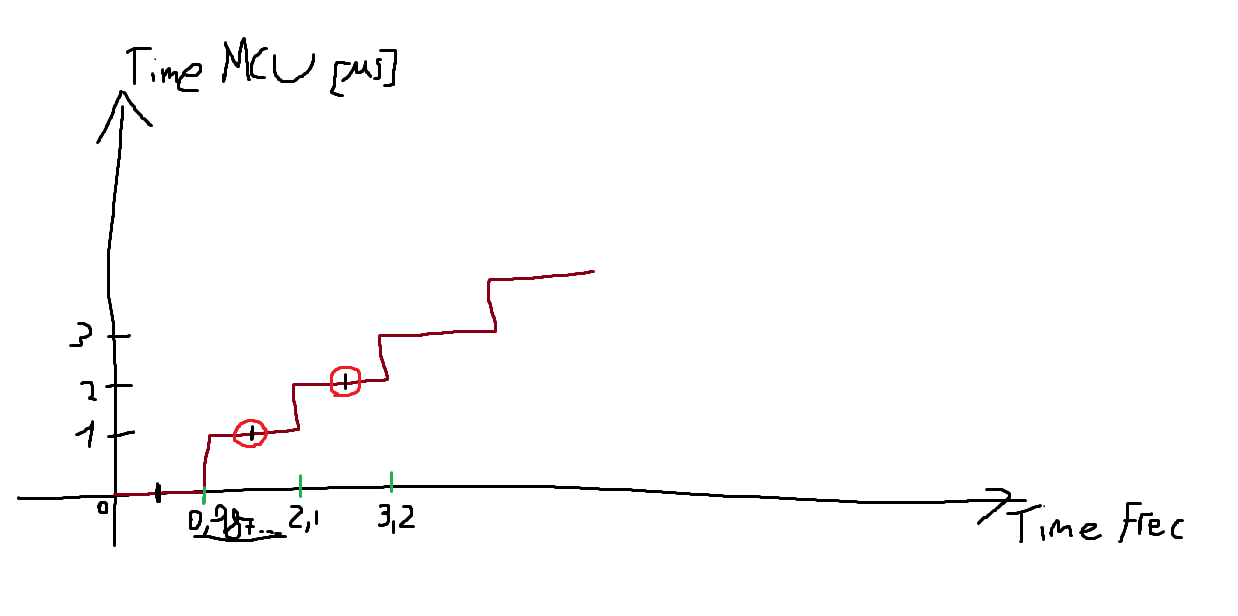
Paints/Calibracion timerIC_2.png
