AleNimo/Bode_Analyzer/Imagenes Manuales/Diagrama Troubleshooting.png

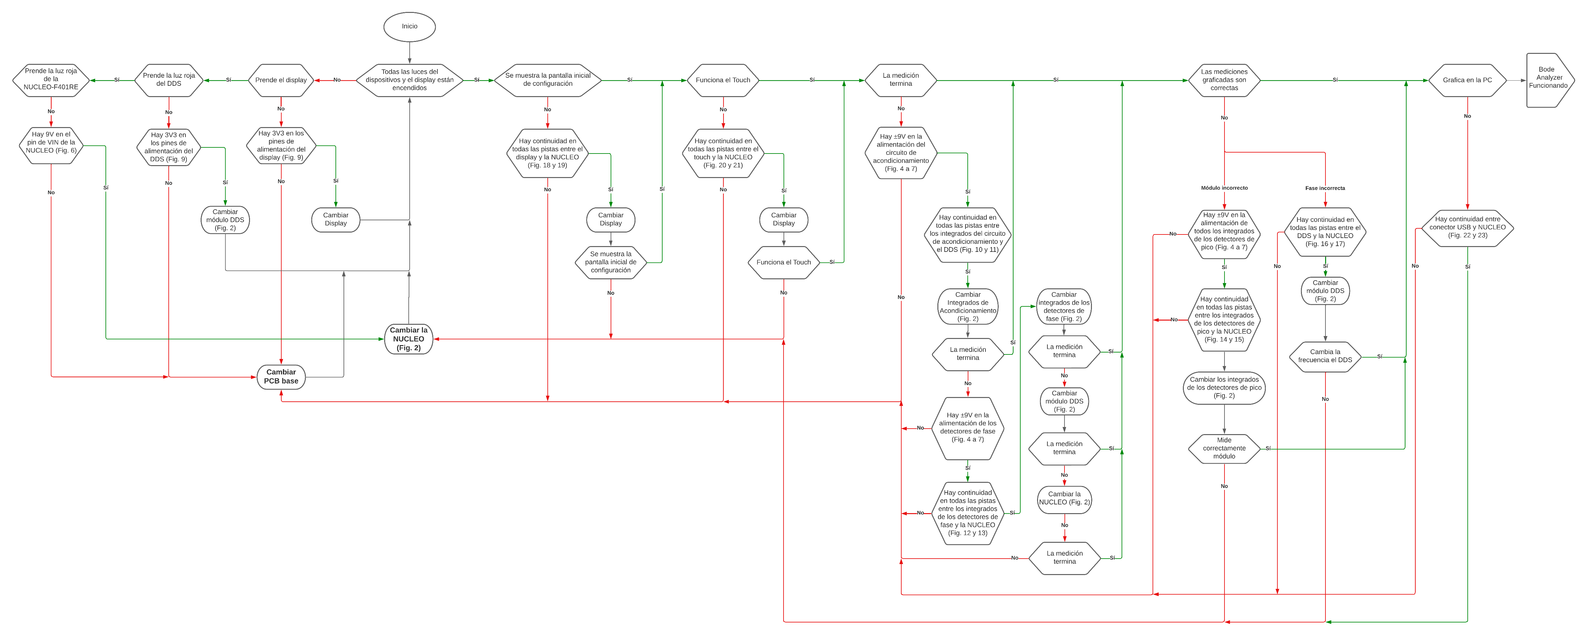
Imagenes Manuales/Diagrama Troubleshooting.png
