AleNimo/Bode_Analyzer/PCB.pdf

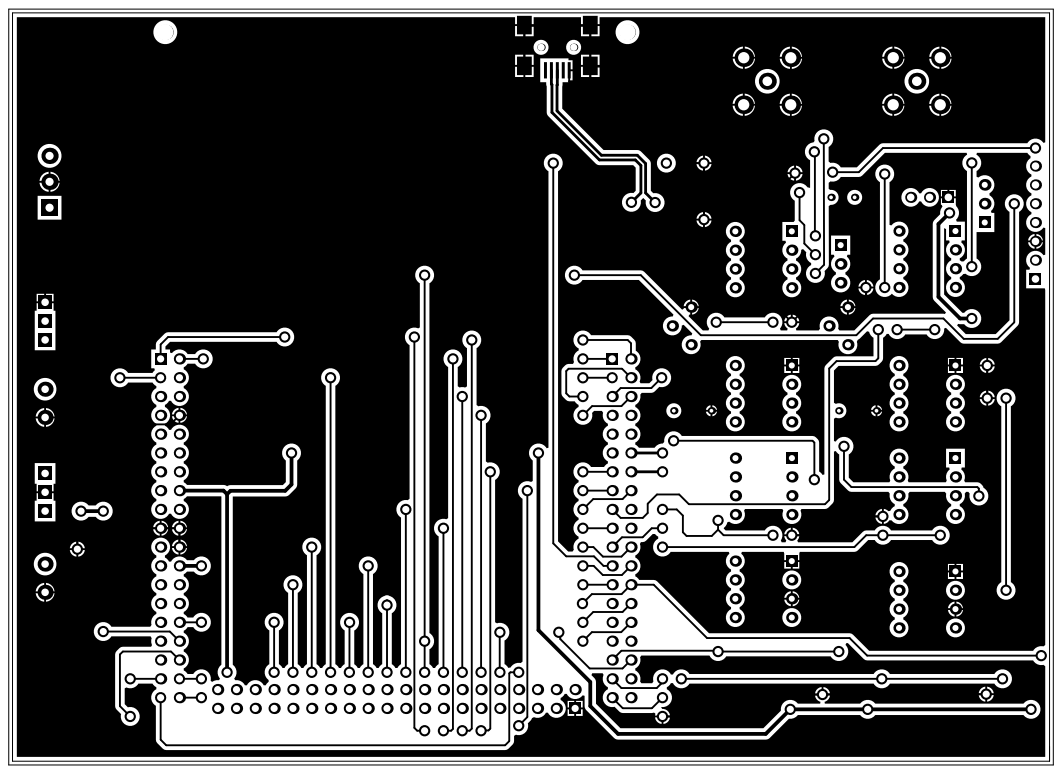
[picture p67: page 1]

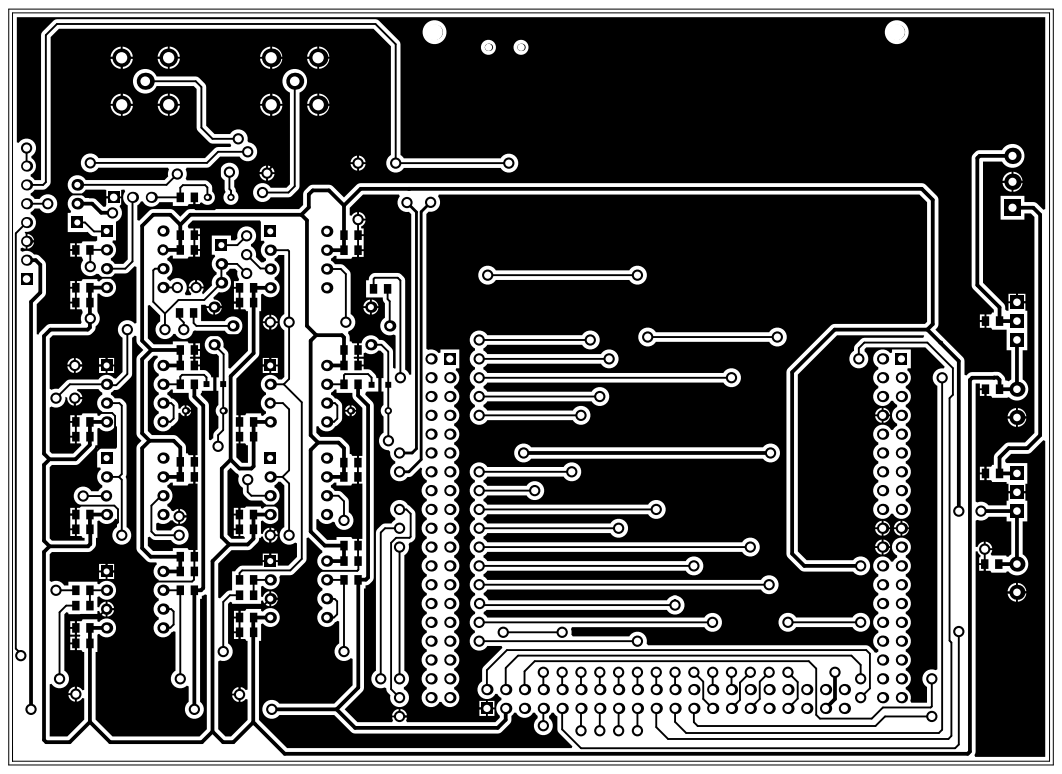
[picture p68: page 2]
