AleNimo/Bode_Analyzer/Circuitos de prueba/Chebyshev.asc

C1: cap; 1µ
C2: cap; 220n
C3: cap; 1n
R1: res; 1k
R2: res; 1470
R3: res; 1k
U1: opamp
V1: voltage; SINE(0 3.3 4.4k); AC 1
Named nets: 0, Vo
.ac dec 600 100 10k
.inc opamp.sub
;tran 0 2.5m 0
