AleNimo/Bode_Analyzer/Circuitos de prueba/PasaAltos.asc

C1: cap; 100n
R1: res; 10k
V1: voltage; ""; AC 1
Named nets: 0, Vo
.ac dec 100 1 1meg
