AleNimo/Bode_Analyzer/Circuitos de prueba/Notch.asc

C1: cap; 100n
C2: cap; 100n
C3: cap; 100n
R1: res; 2k2
R2: res; 2k2
R3: res; 570
V1: voltage; ""; AC 1
Named nets: 0, Vo
.ac dec 1k 1 100k
