AleNimo/Bode_Analyzer/LTspice Hardware/Bode_Analyzer.asc

B2: bv; V=(white(1e6*time)/10)
C1: cap; 100n
C2: cap; 10µ
C3: cap; 100n
C4: cap; 1n
D1: diode; 1N4148
D2: diode; 1N4148
D3: diode; 1N4148
D4: diode; 1N4148
DDS: bv; V=V(V_DDS)+V(noise)
R1: res; 680
R2: res; 680
R5: res; 1k
R6: res; 10k
R9: res; 1k
R10: res; 100k
R13: res; 1k
R14: res; 10k
U1: UniversalOpamp2
U10: UniversalOpamp2
U11: UniversalOpamp2
U12: UniversalOpamp2
U13: UniversalOpamp2
U14: UniversalOpamp2
U15: UniversalOpamp2
U16: UniversalOpamp2
V1: voltage; 12
V2: voltage; 12
V3: voltage; SINE(300m 300m 10k 0 0 0)
V4: voltage; ""; AC 1
Named nets: 0, VCC, -VEE, V_DDS, noise, Vin, V_Zero_Cross_Vin, V_peak_Vin, Vout, V_Zero_Cross_Vout, V_peak_Vout, 3v3
;tran 0 10.5m 10m 1m
.ac dec 1k 0.01 1meg
Desacople Continua y Amplificacion
Sistema
Comparador
Peak Detect
(Emisor a gnd)
(Emisor a gnd)
