AleNimo/Bode_Analyzer/(list of files, drawings)

Other design files:
Bode_Analyzer/BDAN.SchDoc
Bode_Analyzer/BDAN_ACOND.SchDoc
Bode_Analyzer/BDAN_CPU.SchDoc
Bode_Analyzer/BDAN_PWR.SchDoc
Bode_Analyzer/BDAN_TFT.SchDoc
Bode_Analyzer/Bode_Analyzer.PrjPcb
