AleNimo/Bode_Analyzer/Workspace_STM32CubeIDE/Bode_Analyzer/Core/Inc/main.h

#define LOW_FREQ 0
#define HIGH_FREQ 1
#define MOD_SAMPLES 20	//SAMPLES de entrada / SAMPLES de salida tomadas con el ADC
#define PHASE_SAMPLES 10
#define MAX_FREQ_POINTS 600
#define FREQ_TIM1 72000000
#define DB0_Pin GPIO_PIN_0
#define DB0_GPIO_Port GPIOC
#define DB1_Pin GPIO_PIN_1
#define DB1_GPIO_Port GPIOC
#define DB2_Pin GPIO_PIN_2
#define DB2_GPIO_Port GPIOC
#define DB3_Pin GPIO_PIN_3
#define DB3_GPIO_Port GPIOC
#define LCD_RESET_Pin GPIO_PIN_1
#define LCD_RESET_GPIO_Port GPIOA
#define ADC_VIN_Pin GPIO_PIN_2
#define ADC_VIN_GPIO_Port GPIOA
#define ADC_VOUT_Pin GPIO_PIN_3
#define ADC_VOUT_GPIO_Port GPIOA
#define LCD_WR_Pin GPIO_PIN_4
#define LCD_WR_GPIO_Port GPIOA
#define LCD_RD_Pin GPIO_PIN_6
#define LCD_RD_GPIO_Port GPIOA
#define LCD_RS_Pin GPIO_PIN_7
#define LCD_RS_GPIO_Port GPIOA
#define DB4_Pin GPIO_PIN_4
#define DB4_GPIO_Port GPIOC
#define DB5_Pin GPIO_PIN_5
#define DB5_GPIO_Port GPIOC
#define DB13_Pin GPIO_PIN_0
#define DB13_GPIO_Port GPIOB
#define DB14_Pin GPIO_PIN_1
#define DB14_GPIO_Port GPIOB
#define DB15_Pin GPIO_PIN_2
#define DB15_GPIO_Port GPIOB
#define LCD_CS_Pin GPIO_PIN_10
#define LCD_CS_GPIO_Port GPIOB
#define TOUCH_CS_Pin GPIO_PIN_12
#define TOUCH_CS_GPIO_Port GPIOB
#define DB6_Pin GPIO_PIN_6
#define DB6_GPIO_Port GPIOC
#define DB7_Pin GPIO_PIN_7
#define DB7_GPIO_Port GPIOC
#define DB8_Pin GPIO_PIN_8
#define DB8_GPIO_Port GPIOC
#define DB9_Pin GPIO_PIN_9
#define DB9_GPIO_Port GPIOC
#define DDS_CS_Pin GPIO_PIN_8
#define DDS_CS_GPIO_Port GPIOA
#define IC_VIN_Pin GPIO_PIN_9
#define IC_VIN_GPIO_Port GPIOA
#define IC_VOUT_Pin GPIO_PIN_10
#define IC_VOUT_GPIO_Port GPIOA
#define TMS_Pin GPIO_PIN_13
#define TMS_GPIO_Port GPIOA
#define TCK_Pin GPIO_PIN_14
#define TCK_GPIO_Port GPIOA
#define DB10_Pin GPIO_PIN_10
#define DB10_GPIO_Port GPIOC
#define DB11_Pin GPIO_PIN_11
#define DB11_GPIO_Port GPIOC
#define DB12_Pin GPIO_PIN_12
#define DB12_GPIO_Port GPIOC
#define RST_VIN_Pin GPIO_PIN_6
#define RST_VIN_GPIO_Port GPIOB
#define TOUCH_IRQ_Pin GPIO_PIN_8
#define TOUCH_IRQ_GPIO_Port GPIOB
#define RST_VOUT_Pin GPIO_PIN_9
#define RST_VOUT_GPIO_Port GPIOB
