AleNimo/Bode_Analyzer/Workspace_STM32CubeIDE/Bode_Analyzer/Core/Inc/transferenciaADC_calibrado.h

/*
 * transferenciaADC_calibrado.h
 *
 *  Created on: 27 dic. 2022
 *      Author: Alejo
 */

#ifndef INC_TRANSFERENCIAADC_CALIBRADO_H_
#define INC_TRANSFERENCIAADC_CALIBRADO_H_

const uint16_t CODIGOS_ADC[] =
{
		0,
		4,
		7,
		8,
		9,
		12,
		14,
		16,
		18,
		22,
		24,
		28,
		30,
		32,
		36,
		40,
		44,
		48,
		50,
		52,
		56,
		60,
		64,
		68,
		70,
		72,
		76,
		80,
		84,
		88,
		92,
		94,
		100,
		102,
		104,
		112,
		115,
		116,
		118,
		120,
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
};

const float TENSIONES_ADC[] =
{
		0.0032258064516129032,
		0.0064516129032258064,
		0.008870967741935484,
		0.00967741935483871,
		0.01075268817204301,
		0.012903225806451613,
		0.014516129032258063,
		0.016129032258064516,
		0.017741935483870968,
		0.02096774193548387,
		0.02258064516129032,
		0.025806451612903226,
		0.027419354838709678,
		0.02903225806451613,
		0.03225806451612903,
		0.035483870967741936,
		0.03870967741935484,
		0.041935483870967745,
		0.043548387096774194,
		0.04516129032258065,
		0.04838709677419354,
		0.05161290322580645,
		0.054838709677419356,
		0.05806451612903226,
		0.05967741935483871,
		0.06129032258064516,
		0.06451612903225806,
		0.06774193548387097,
		0.07096774193548387,
		0.07419354838709677,
		0.07741935483870968,
		0.07903225806451614,
		0.08387096774193549,
		0.08548387096774193,
		0.08709677419354839,
		0.0935483870967742,
		0.09596774193548387,
		0.0967741935483871,
		0.09838709677419355,
		0.1,
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
};

#endif /* INC_TRANSFERENCIAADC_CALIBRADO_H_ */
