AleNimo/Bode_Analyzer/Workspace_STM32CubeIDE/Bode_Analyzer/Core/Inc/timer_calibrado.h

#ifndef INC_TIMER_CALIBRADO_H_
#define INC_TIMER_CALIBRADO_H_

const uint32_t TIME_US_MCU[] =
{
		1,
		2,
		3,
		5,
		10,
		19,
		33,
		60,
		107,
		191,
		342,
		614,
		1101,
		1975,
		3539,
		6352,
		11352,
		20385,
		36552,
		65524,
		93604,
		294445,
		488884,
		844433,
		1000000
};

const uint32_t TIME_US_PATRON[] =
{
		1,
		2,
		3,
		5,
		10,
		19,
		33,
		60,
		107,
		191,
		342,
		614,
		1101,
		1975,
		3540,
		6352,
		11352,
		20385,
		36552,
		65525,
		100157,
		301692,
		496085,
		851305,
		1007109
};

#endif /* INC_TIMER_CALIBRADO_H_ */
