AleNimo/Bode_Analyzer/(commit log)

2022-11-18 Cambio a AD9833_Init()
    seteo la frecuencia al final y ahora funciona siempre
2022-11-18 COMITEA VERGA
    [BDAN.SchDoc, BDAN_ACOND.SchDoc, BDAN_CPU.SchDoc, BDAN_TFT.SchDoc, Bode_Analyzer.PrjPcb]
2022-11-18 A la mierda la carpeta history
2022-11-18 Cambio al gitignore para altium
2022-11-19 update .gitignore
    Cambio cosas en la parte de altium
2022-11-29 Pruebas a realizar, y update de ltspice
2022-11-30 Proyecto unificado. TouchGFX funcionando con RTOS
    [Agregar la coma.xlsx, BDAN_ACOND.SchDoc, BDAN_CPU.SchDoc]
2022-12-01 Antes de cambiar nombre
2022-12-01 Cambio nombre proyecto de software a Bode_Analyzer
2022-12-02 Calculo de freq[]
    Agregado de funcion que calcula vector de frecuencias a partir de valores freq_min, freq_max, y puntos por decada
2022-12-02 Agrego scripts de filtro de goertzel
2022-12-02 Informo Fmin, Fmax y puntos de sliders
2022-12-02 Achico gráfico y cambio simbolo de fase
2022-12-03 Sliders funcionando
    Correccion de bugs de labels de frecuencia.
    Sliders recuerdan su valor.
    Mensaje de error si Fmin > Fmax (y deshabilito botón de ok).
    Título agregado a los gráficos de módulo y fase.
    [AD9833.c, ILI9341.c, main.h]
2022-12-03 Armo fuente, corrijo nets de CPU
    [BDAN.SchDoc, BDAN_ACOND.SchDoc, BDAN_CPU.SchDoc, BDAN_TFT.SchDoc, Bode_Analyzer.PrjPcb]
2022-12-04 Agrego sch de pwr
    [BDAN_PWR.SchDoc]
2022-12-04 Agrego links en sch para los BNC
    [BDAN_ACOND.SchDoc]
2022-12-04 Pines de DDS corregidos
    [BDAN_CPU.SchDoc]
2022-12-05 Cambios a Hardware
    Detector de pico con comparador.
    Comparadores con histéresis para evitar ruido.
    Usamos Vin de la núcleo para evitar ruido de alimentación de usb.
    [BDAN_ACOND.SchDoc, BDAN_CPU.SchDoc]
2022-12-05 Agrego bnc, armo nuevo peak-detect, pongo señales independientes para reset cap,
    [BDAN_ACOND.SchDoc, BDAN_CPU.SchDoc]
2022-12-05 Agrego componente de nucleo y ili9341, tiro componentes a pcb, empiezo a ordenar circuitos
    [BDAN.SchDoc, BDAN_ACOND.SchDoc, BDAN_CPU.SchDoc, BDAN_PWR.SchDoc, BDAN_TFT.SchDoc]
2022-12-05 Implemento medición de magnitud
    Promediando 8 valores de entrada y 8 de salida.
    Falta implementar la transformación de cuentas a tensión en función de la transferencia calibrada del ADC.
2022-12-06 Ordeno circuitos en pcb
2022-12-07 Ruteo placa, modifico circuito de reset
    [BDAN_ACOND.SchDoc, BDAN_CPU.SchDoc, Bode_Analyzer.xlsx]
2022-12-07 ioc con pines cambiados, agrego código para medir fase
2022-12-07 Libero cobre del top abajo de los bnc Routeo reset cap Agrego componentes del reset a bom
    [BDAN_ACOND.SchDoc, BDAN_CPU.SchDoc, Bode_Analyzer.xlsx]
2022-12-07 Modifico footprint usb y tft
2022-12-07 Agrego config de prescaler de tim1 segun freq
2022-12-13 Cambio parametros de SPI para usar DDS y touch
2022-12-14 Primeras mediciones de fase
    Problema con clock config, se desactivó el usb y se cambió la config para que funcione
    Se agrego delay inicial para estabilizar el cap de filtrado de continua
    Mide fase correctamente con prescaler de 83, hasta 1K
    [Bode_Analyzer.ioc, main.c]
2022-12-15 Avance medición Fase, Peleando con medicion de modulo (ADC)
2022-12-15 Arreglo a bug en eje de frecuencias
    ADC funciona, era problema de HW (pines soldados a uart de stlink en lugar de conectores macho de nucleo)
    [main.c]
2022-12-16 Compilacion de bode_analyzer
2022-12-16 cambio .gitignore de qt
2022-12-18 Agrego Proyecto de juan de USB, avances con USB
    Envía cantidad de puntos y luego vector de frecuencia, falta que pueda enviar vectores de fase y magnitud
2022-12-19 USB funcionando, Cambios a fase
    Tratando de medir fase con discontinuidades
2022-12-19 Medicion de fase 2.0
    [Agregar la coma.xlsx]
2022-12-19 USB agregado
    (HW cambiamos a un cap de 220nF el detector de pico de la salida del filtro)
2022-12-21 Cambio esquematico placa; Delay fijo de capacitores en codigo
    [BDAN_ACOND.SchDoc]
2022-12-24 Barra de progreso al medir
2022-12-28 Agrego calibraciones al bode. QT modificado, falta calcular incertidumbres combinadas.
    Al medir se realiza interpolación lineal con la transferencia obtenida del ADC, e inter. lineal del valor medido del timer.
    El envío de datos por usb se realiza distinto, mandando 10 muestras medidas de vin, vout y fase por cada frecuencia. El qt se modificó acorde.
    [calibracion_timer_stm.csv, codigosADC.csv, mediciones_adc_proyecto.csv, tensionIn_ADC.csv, transferenciaADC.csv]
2022-12-29 USB funcionando con qt
    Falta informar a qt cuándo no se mide la fase en lugar de enviar timediff constante
    [TEK0000.CSV, TEK0001.CSV, TEK0002.CSV, TEK0003.CSV, TEK0004.CSV, TEK0005.CSV, TEK0006.CSV, TEK0007.CSV]
2023-01-05 Ensayo THD e imagenes para paper
    [TEK0000.CSV, TEK0002.CSV, TEK0013.CSV, TEK0014.CSV, TEK0015.CSV, TEK0016.CSV, TEK0017.CSV, TEK0018.CSV]
2023-02-09 Modifico resistencia de realimentacion de comparadores (cruce por cero a 100k), modifico descarga cap Vout a 220nF Arreglo PCB luego de hacer update Actualizo BOM
    [BDAN_ACOND.SchDoc, Bode_Analyzer.xlsx]
2023-02-09 Elimino comentarios de vectores en main.c
2023-03-03 Agregado de imagenes para manuales, manuales en pdf, paper
    También agregado título de "Bode Analyzer" a la App de qt
