AleNimo/Bode_Analyzer/(notices)

Notices in the files:
Workspace_STM32CubeIDE/Bode_Analyzer/Core/Src/main.c:
Copyright (c) 2022 STMicroelectronics.
All rights reserved.
This software is licensed under terms that can be found in the LICENSE file
